Velmi/guitar-dispo/README.md

# guitar-dispo
Digital signal processing on a STM32 Nucleo Board
