Velmi/guitar-dispo/doc/report/notes.txt

- Latenz/Delay
- RTOS
- Filterlänge, Cutoff
- Fensterung?
- Realtime
