Velmi/guitar-dispo/doc/report/sources/acro.tex

\section*{List of Abbreviations}

\begin{acronym}[DMA]
    \acro{ADC}{Analog-Digital Converter}
    \acroplural{ADC}[ADCs]{Analog-Digital Converters}
    \acro{CLI}{Command Line Interface}
    \acro{CPU}{Central Processing Unit}
    \acro{DAC}{Digital-Analog Converter}
    \acro{DMA}{Direct Memory Access}
    \acro{DSP}{Digital Signal Processor}
    \acro{EDA}{Electronic Design Automation}
    \acro{FFT}{Fast Fourier Transform}
    \acro{FIR}{Finite Impulse Response}
    \acro{IC}{Integrated Circuit}
    \acroplural{IC}[ICs]{Integrated Circuits}
    \acro{IDE}{Integrated Development Environment}
    \acro{IIR}{Infinte Impulse Response}
    \acro{I2C}[I\textsuperscript{2}C]{Inter-Integrated Circuit}
    \acro{I2S}[I\textsuperscript{2}S]{Inter-Integrated Sound}
    \acro{LTI}{Linear Time Invariant}
    \acro{LTV}{Linear Time Variant}
    \acro{MSB}{Most Significant Bit}
    \acro{PCB}{Printed Circuit Board}
    \acro{RAM}{Random Access Memory}
    \acro{SPI}{Serial Peripheral Interface}
\end{acronym}
