Velmi/guitar-dispo/doc/report/sources/appendix.tex

\appendix

\section{Schematic}

\includepdf[pages=-]{../../hardware/dispo-board/dispo-board.pdf}

\section{\ac{PCB}}

\begin{figure}[!h]
    \centering
    
    \caption{The built \ac{PCB} with all modifications and connectors}
    \label{fig:pcb}
\end{figure}
