Velmi/guitar-dispo/doc/report/sources/concept.tex

\section{Requirements and concept}

\subsection{Challenges and requirements in Audio Signal Processing}

\subsubsection{Latency}

As we have to sample a block of data in the digital domain, there is a latency between the input and output
depending on some parameters. Firstly the buffer size has a large impact on the latency. The greater the buffer, the
greater the latency. It is application depending what latency is acceptable, this is why that parameter
limits the system and should be evaluated carefully.

Secondly other components, which are application depending, adds latency to the whole signal path.
For example filtering or other modifications take some time to be computed. Also the signal has to
be converted from analog to digital and transmitted over an interface. All these components latencies add
up to an overall system latency. 

In this application, where a guitar signal is processed, the overall latency of the system should be less
than 5\,ms \cite{beckmann_dsp}.

\subsubsection{Packet losses and cracking noise}

In some audio applications cracking noise can occur. This is due to
some impulses on the audio signal. This can be caused by an error of the input sample, for example particles
on a vinyl record, or by slow implementations of digital signal processing algorithms.

If the processing of the input data takes longer than the actual transfer, packets of audio data will
then be dropped. An impulse or step on the output data will be seen, this can be heard as a cracking noise
\cite{stotz_audio_video}.

\subsection{Concept}

The basic concept is shown in \autoref{fig:basic-concept}.

\begin{figure}[!h]
    \centering
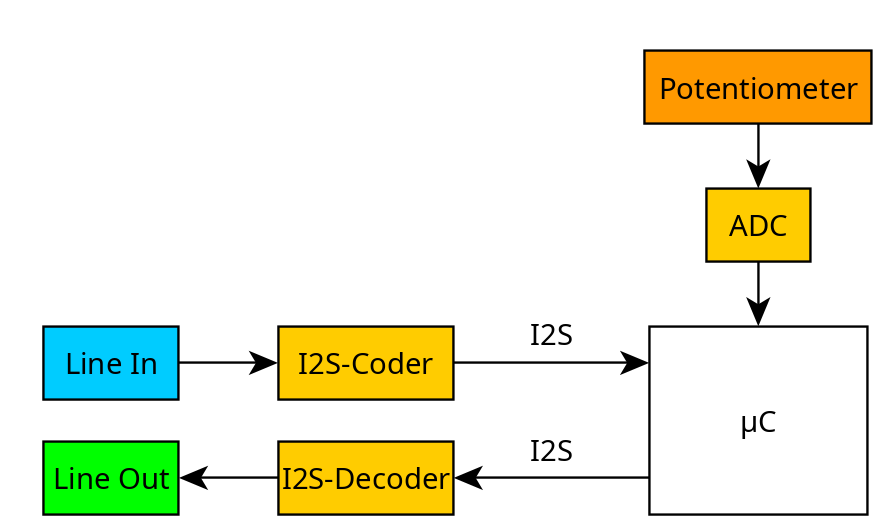
[picture p13: doc/report/img/basic_concept.png]
    
    \caption{Basic concept}
    \label{fig:basic-concept}
\end{figure}

The input data is coming from the Line In, is sampled by a \ac{ADC} and transmitted
over \ac{I2S} to the microcontroller. There the data will be processed and the output will be transmitted
again over \ac{I2S} to a \ac{DAC}. The output is again routed to a Line Jack.

Additionally a potentiometer is connected to set the midfrequency of the filter.

To ensure an adequate sampling rate for audio quality, the frequency is selected to be 48\,kHz.

\subsubsection{Signalflow}

The basic idea is to filter the input signal with a bandpass filter. The mid frequency should be derived
from a potentiometer which is simply connected to an \ac{ADC} inside the microcontroller. It has to be evaluated
how exaclty the filter is adjusted.

The first attempt will be a lookup-table and everytime the position of the
potentiometer changes, the corresponding filter coefficients will be loaded.

The second approach is, to calculate the filter coefficients for a biquad-filter if the value of the potentiometer changes.
This is reasonable to evaluate as the number of coefficients is small in comparison to a \ac{FIR}-filter.

\subsubsection{Double Buffering and DMA}

To solve the problem with packet losses it is recommended to use the double buffering method.
It is basically a buffer which is cut in half. If the first half is filled with data then this half
will be processed while the other half is filled with the second half of the input data. Is the second
half filled then this half will be processed and so on.

The advantage is that it is not necessary to wait for the whole input data block to process.
This will reduce the time between processing and sampling data \cite{eetimes_fund_dsp}.

To take advantage of this, it is useful to combine this technique with a \ac{DMA},
which is already discussed in section \ref{sec:dma}.

%// TODO ausführlicher

The whole procedure is shown in \autoref{fig:double-buffering}.

\begin{figure}[!h]
    \centering
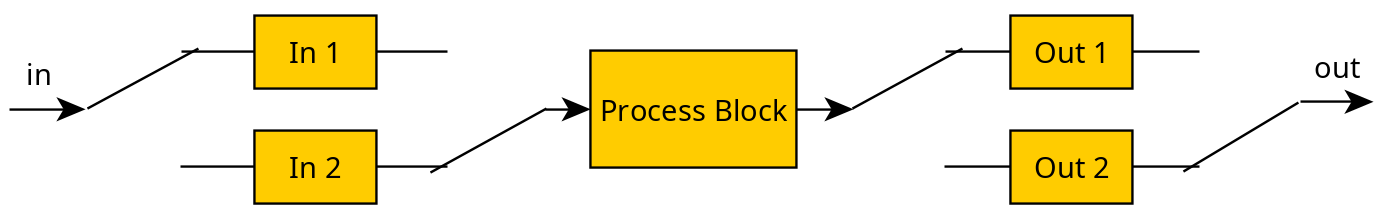
[picture p14: doc/report/img/double_buffering.PNG]
    
    \caption{Double buffering concept \cite{eetimes_fund_dsp}}
    \label{fig:double-buffering}
\end{figure}

\subsubsection{Design criteria}

As the goal is to develop a variable bandpass filter, not only a set of coefficients for one filter has to be stored,
but many versions of this filter with different mid-frequencies.

As a reference, the frequency response of the \textit{Cry-Baby}-Pedal has been measured, which is
shown in \autoref{fig:wahwah-filter}.

\begin{figure}[!h]
    \centering
    \begin{subfigure}[c]{0.45\textwidth}
        \centering
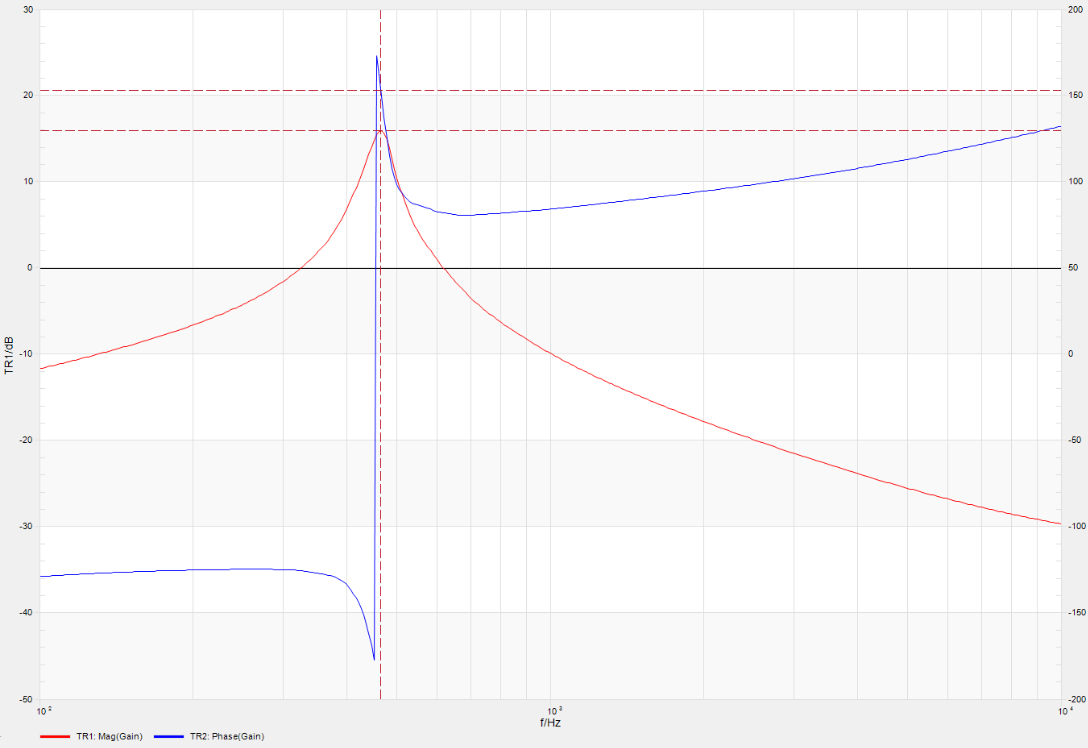
[picture p15: doc/report/img/wahwah-1.png]
        
    \end{subfigure}
    \begin{subfigure}[c]{0.45\textwidth}
        \centering
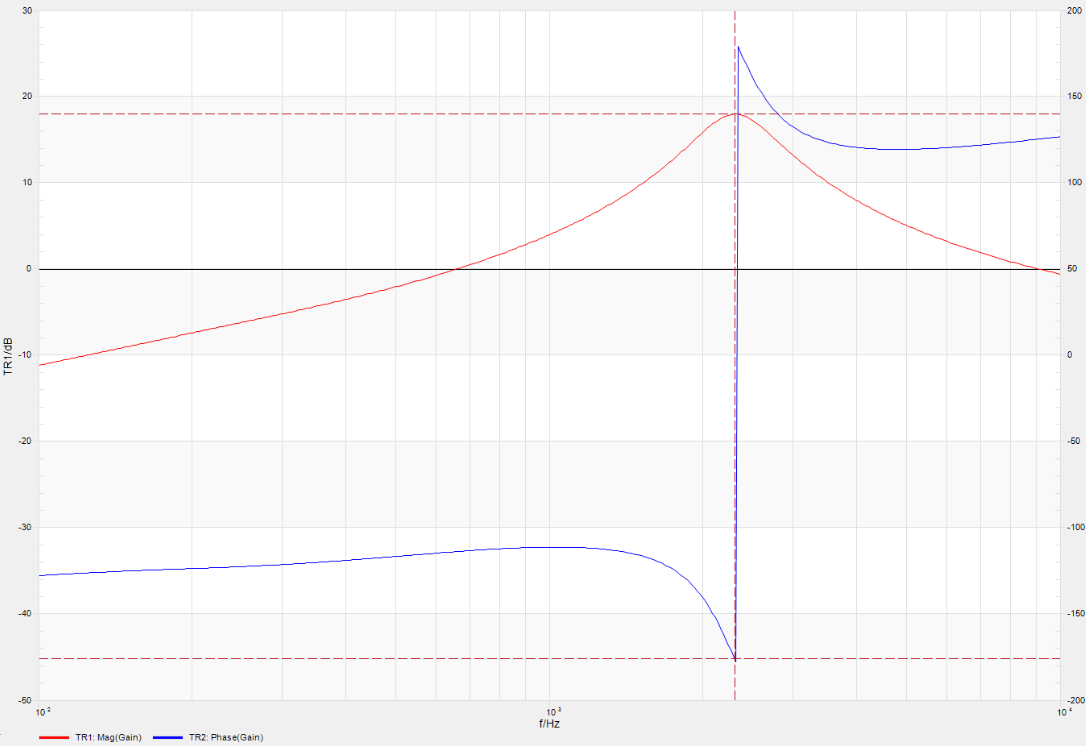
[picture p16: doc/report/img/wahwah-2.png]
        
    \end{subfigure}
    \caption{Measurement of the frequency response of a Wah-Wah-pedal at the lowest and highest frequencies}
    \label{fig:wahwah-filter}
\end{figure}

The resonance frequency of this filter varies between 466\,Hz and 2,3\,kHz.

It is also to be seen, that as the frequency changes, the bandwidth also seem to change. Firstly, it has to be mentioned
that this is a logarithmic scale. Nevertheless, by measuring the bandwidths of this filter, it turns out, that the quality
factor also changes.
The bandwidth at 466\,Hz is measured to be 54\,Hz, which leads to a Q-factor of:

\begin{align}
    Q = \frac{466\,Hz}{54\,Hz} = 8,63
\end{align}

At 2,3\,kHz the bandwidth is 600\,Hz resulting in a quality factor of:

\begin{align}
    Q = \frac{2,3\,kHz}{600\,Hz} = 3,833
\end{align}

To keep the Q-factor constant, with increasing the resonance frequency, the bandwidth also has to increase
(\autoref{eq:q-factor}) \cite{taschenbuch_et}.

For the design of the digital filters, it is assumed, that a constant quality-factor is sufficient to model
the analog reference.

To conclude, there are two design criteria for the filters which can be derived.

\begin{itemize}
    \item mid-frequency varies from 460\,Hz to 2,3\,kHz
    \item it is assumed, that a comparable filter is achieved by using a constant quality-factor of 5
\end{itemize}

Another factor is the buffer size, as it has a direct effect on the overall latency.
Because it is not necessary to use a big buffer size, the choice fell on 128 samples, which means
64 samples per processing step, as double buffering is used. This is also evaluated in later steps.
