Velmi/guitar-dispo/doc/report/sources/titlepage_hka.tex

\definecolor{hkagreen}{RGB}{29, 154, 67}
\begin{titlepage}

    \begin{textblock*}{60px}(160mm,10mm)
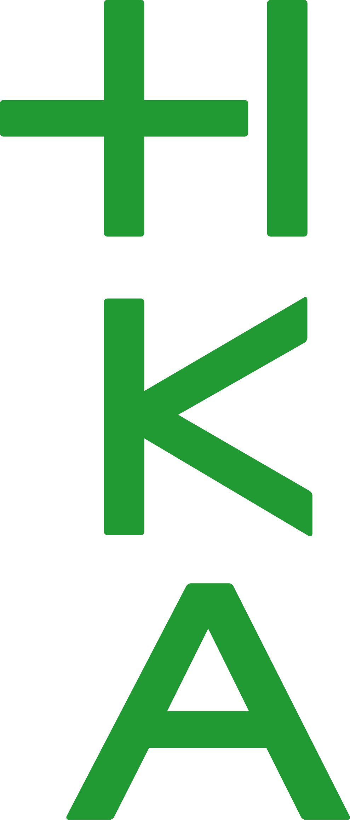
[picture p28: doc/report/img/hka-vertical.png]
		
	\end{textblock*}
    \begin{textblock*}{60px}(30mm,10mm)
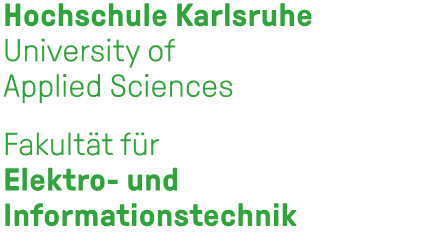
[picture p29: doc/report/img/hka.png]
		
	\end{textblock*}

    \vspace*{5cm}
    \sffamily
    \begingroup
        \fontsize{14pt}{20pt}\selectfont
        \course -\\
        Information Engineering
    \endgroup

    \vspace*{2cm}

    \begingroup
        \fontsize{24pt}{26pt}\selectfont
        \textcolor{hkagreen}{\textbf{Project}}
        \color{black}
    \endgroup

    \vspace*{1cm}

    \begingroup
        \fontsize{20pt}{24pt}\selectfont
        \textbf{\mytitle}
    \endgroup

    \vspace*{7cm}

    \begin{flushleft}
        \begin{tabular}{ll}
            \textbf{Author:} & \myauthor\\
            \textbf{Semester:} & \semester\\
            \textbf{Professor:} & \prof\\
            %\textbf{Abgabetermin:} & \abgabeTermin\\
        \end{tabular}
    \end{flushleft}

    \rmfamily
\end{titlepage}
