Velmi/guitar-dispo/doc/wahwah_presentation.pdf

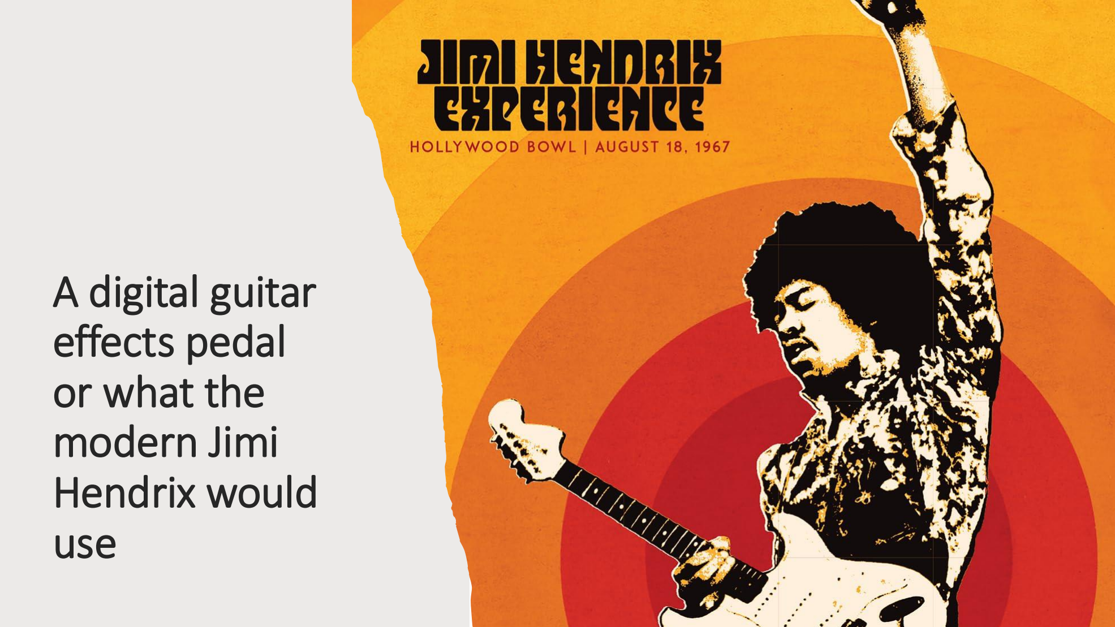
[picture p30: page 1]

## A digital guitar effects pedal or what the modern Jimi Hendrix would use

## Idea

- Digital replica of Wah-Wah pedal

## What is the Wah-Waheffect?

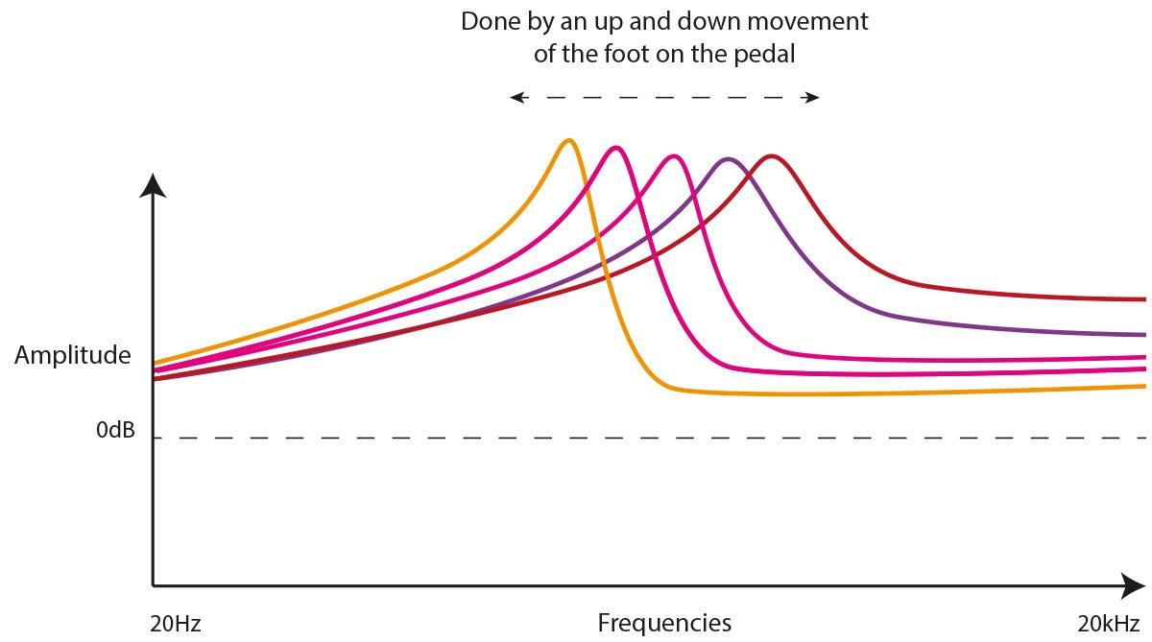
[picture p31: figure]

Source: https://www.3d-varius.com/history-of-the-wah/

## Concept

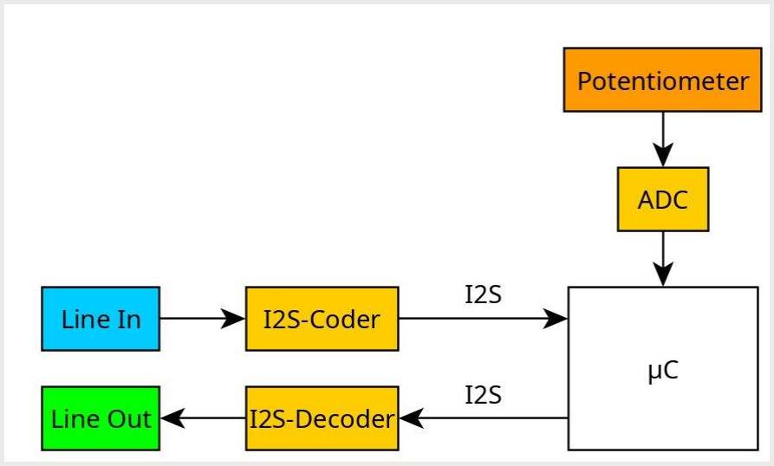
[picture p32: figure]

## Digital Filters

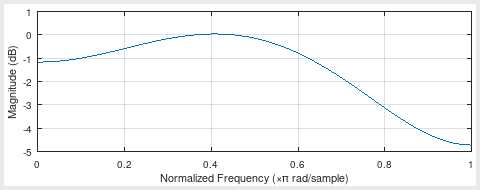
[picture p33: figure]

### FIR

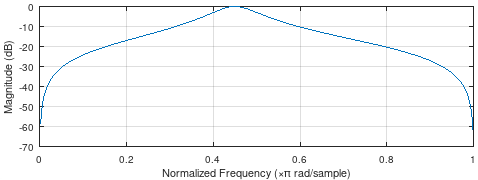
[picture p34: figure]

### IIR

- 5 Coefficients
- Passband from 0.4 to 0.6 Hz

## Biquad Filters

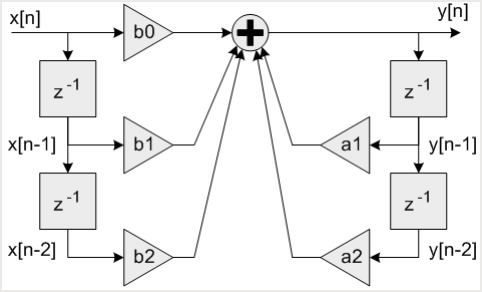
[picture p35: figure]

Source:
https://www.keil.com/pack/doc/CMSIS_Dev/DSP/html/group__BiquadCascadeDF1.html

## Analog reference

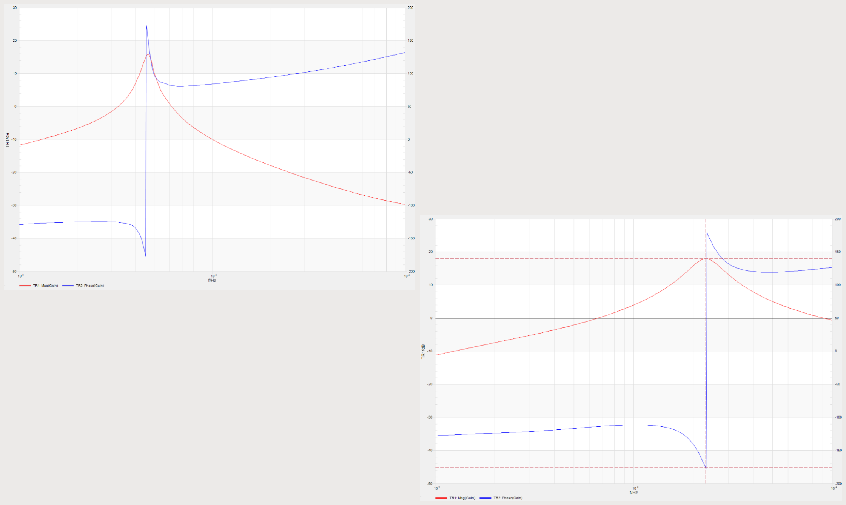
[picture p36: figure]

## Filterdesign

- Constant quality factor 5
- 460 Hz to 2.3 kHz

## FIR Implementation

- 130 coefficients

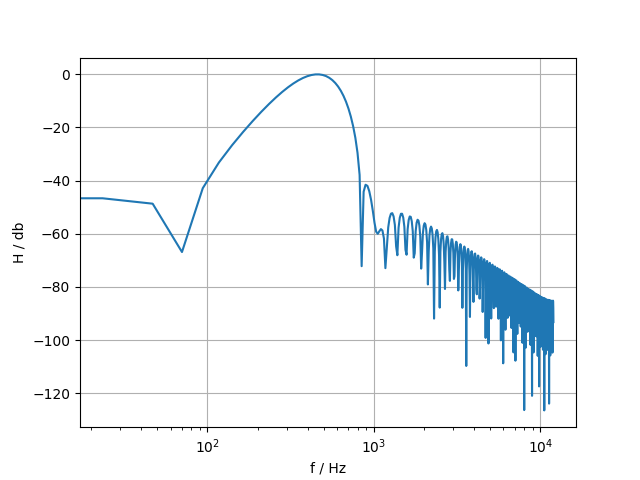
[picture p37: figure]
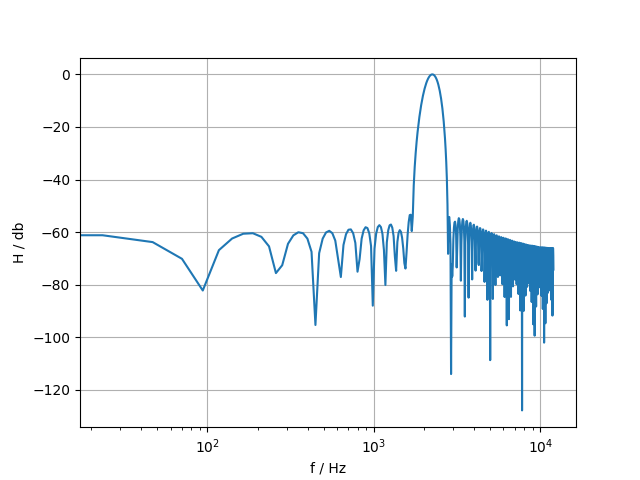
[picture p38: figure]

## IIR Implementation

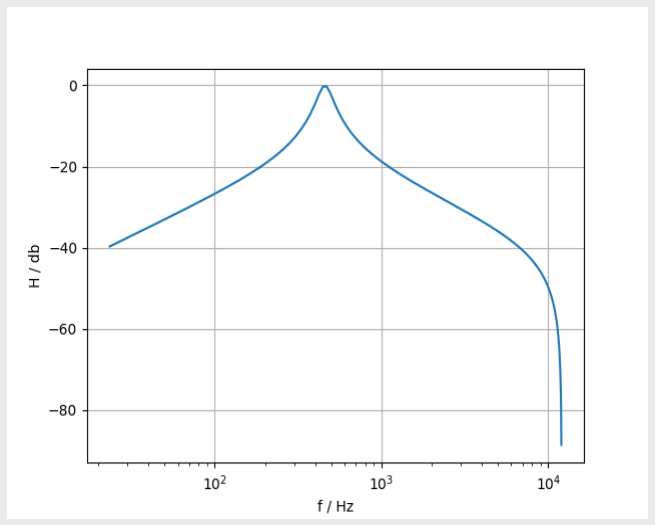
[picture p39: figure]
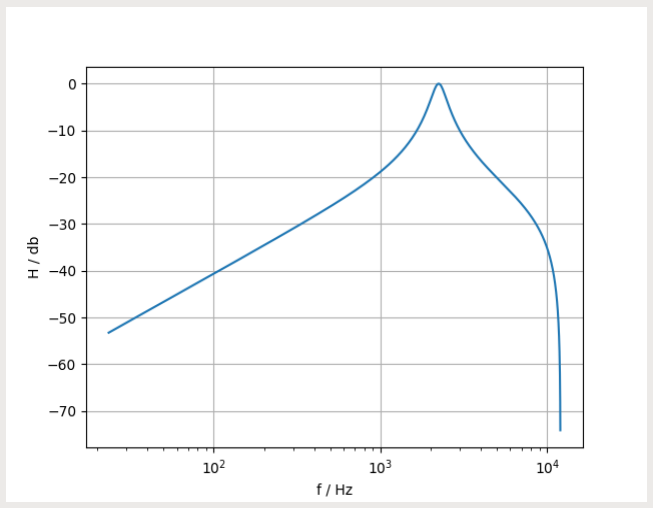
[picture p40: figure]

- Biquad filter
- 5 coefficients

## FIR Implementation -Measurement

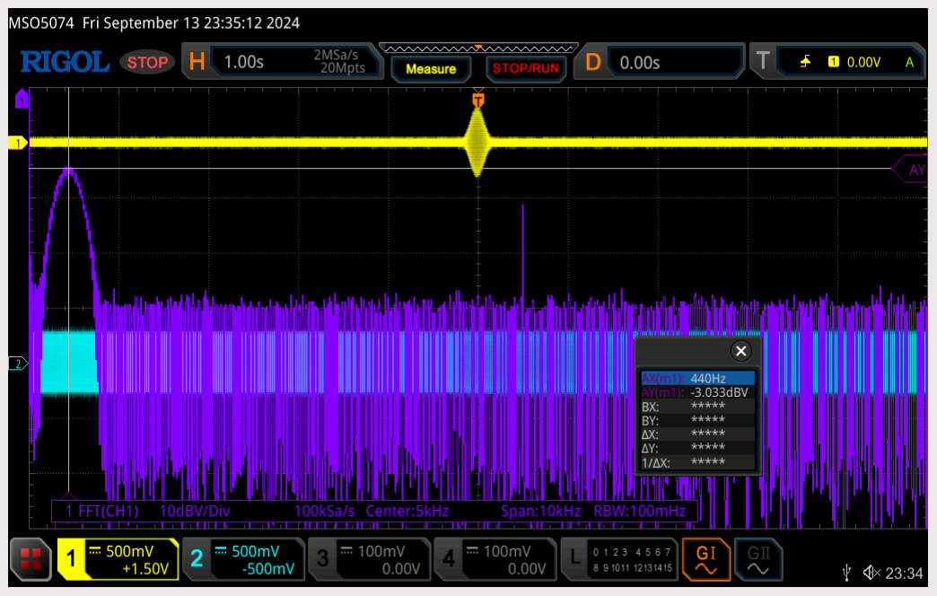
[picture p41: figure]
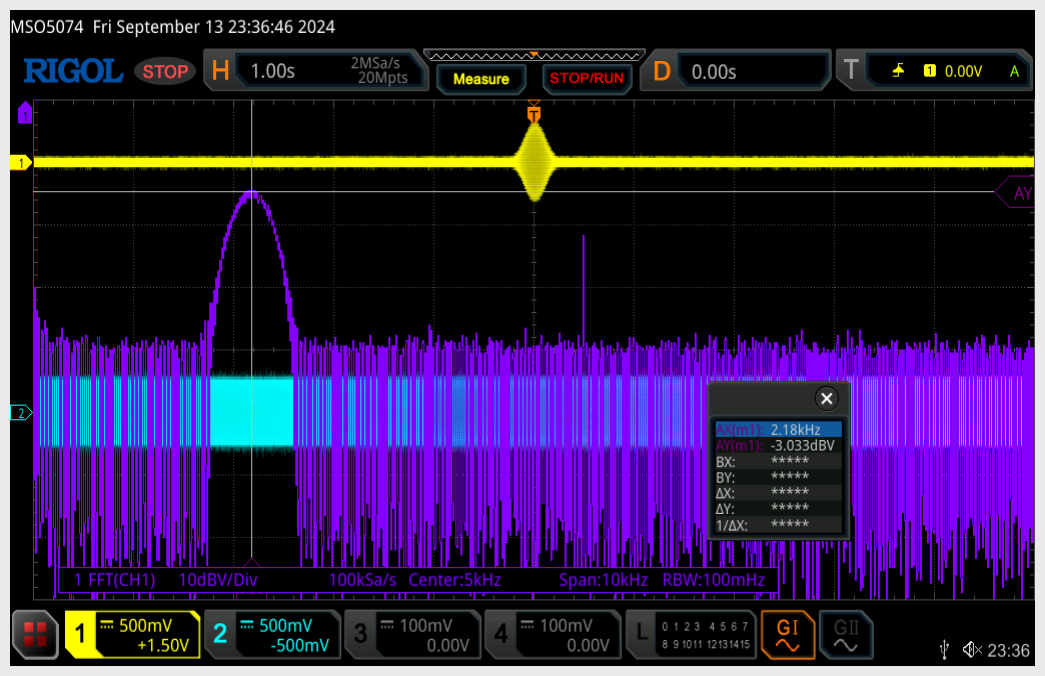
[picture p42: figure]

## IIR Implementation -Measurement

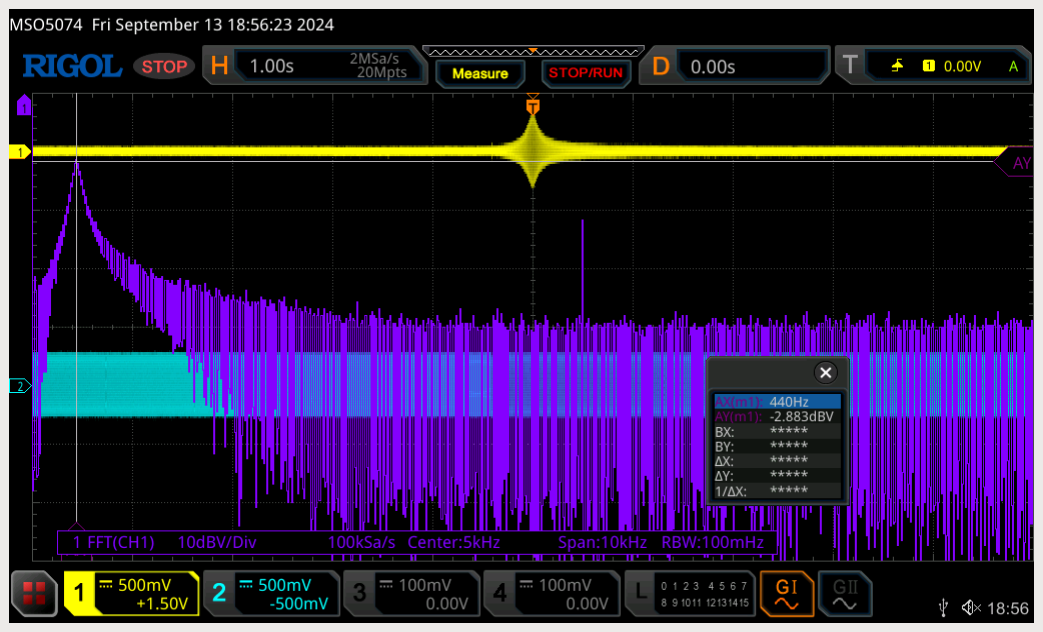
[picture p43: figure]
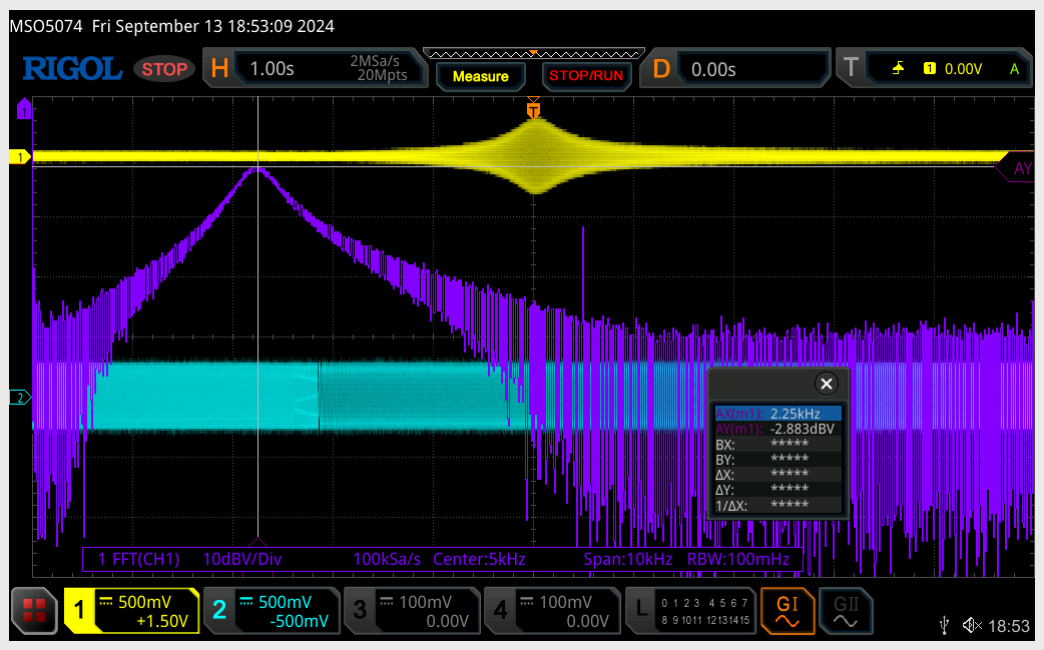
[picture p44: figure]

## Demo

## Conclusion

- Replica of Wah-Wah-pedal successful
- FIR not suitable
- Single-stage biquad filter provide appropriate results
- Base for additional effects
