Velmi/guitar-dispo/doc/report/img/analog_bandpass.png

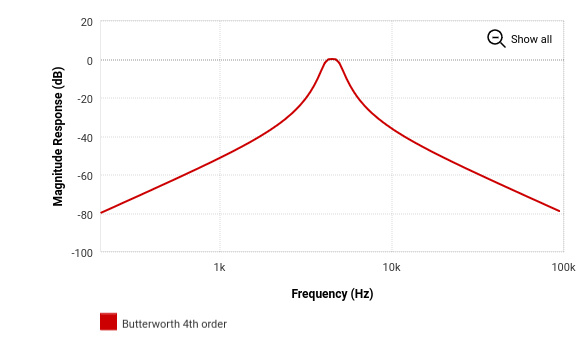
doc/report/img/analog_bandpass.png
