Velmi/guitar-dispo/doc/report/img/double_buffering_dma.PNG

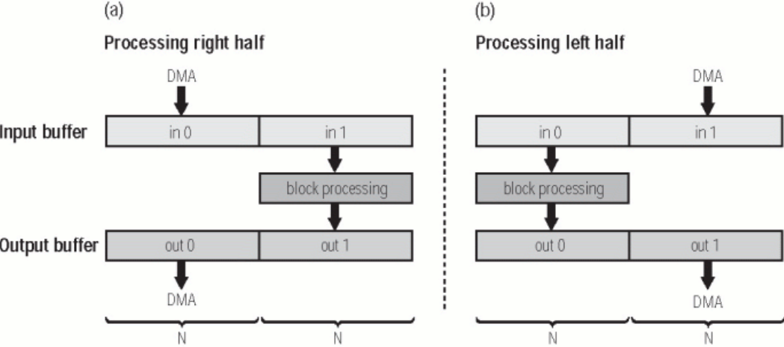
doc/report/img/double_buffering_dma.PNG
