Velmi/guitar-dispo/doc/report/img/hka2.png

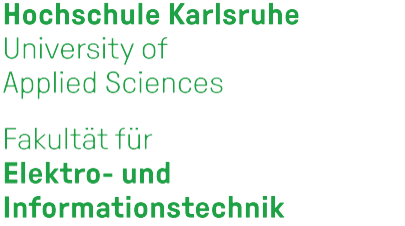
doc/report/img/hka2.png
