Velmi/guitar-dispo/doc/report/img/passthrough.png

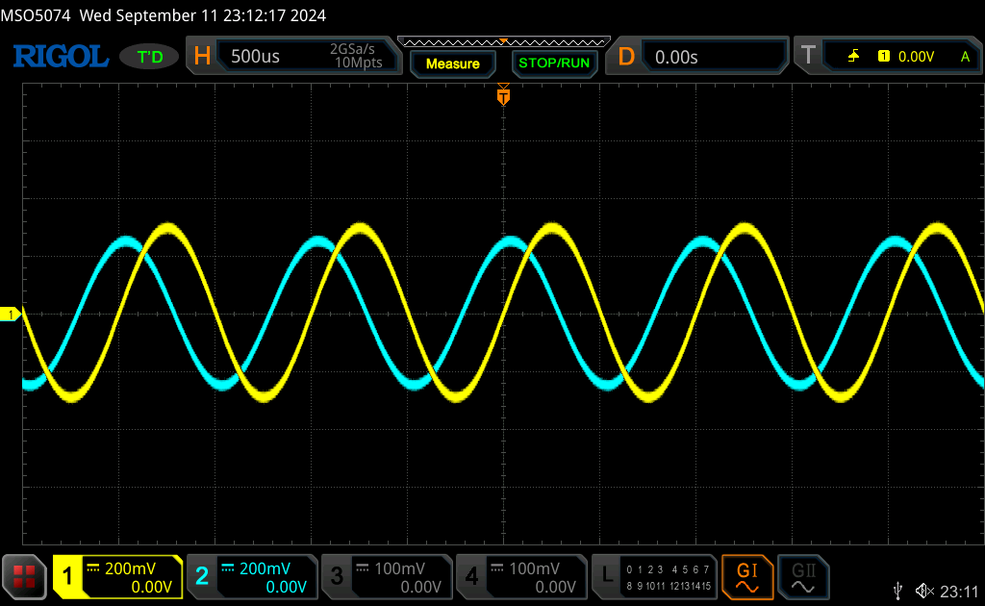
doc/report/img/passthrough.png
