Velmi/guitar-dispo/hardware/dispo-board/bom_expanded.ods

Source: | /run/media/markus/Daten/git/guitar-dispo/hardware/dispo-board/dispo-board.kicad_sch
Date: | Do 02 Mai 2024 22:40:40 CST | 2
Tool: | Eeschema 7.0.10
Generator: | /usr/share/kicad/plugins/bom_csv_grouped_by_value.py
Component Count: | 99
Collated Components:
Item | Qty | Reference(s) | Value | LibPart | Footprint | Datasheet | DNP | Exact Model | MOUSER_NR | THOMANN_NR | CONRAD_NR | REICHELT_NR
1 | 22 | C1, C2, C3, C4, C5, C6, C12, C24, C28, C30, C35 | 100n | Device:C | Capacitor_SMD:C_0402_1005Metric | https://www.mouser.de/datasheet/2/281/1/GRM155R61A104KA01_02A-1983866.pdf |  |  | 81-GRM15R61A104KA01J
2 | 10 | C7, C27, C29, C34, C36 | 10u | Device:C | Capacitor_SMD:C_0603_1608Metric | https://www.mouser.de/datasheet/2/281/1/GRM188C81A106MA73_01A-1985758.pdf |  |  | 81-GRM188C81A106MA3D
3 | 6 | C8, C14, C33 | 10n | Device:C | Capacitor_SMD:C_0402_1005Metric | https://www.mouser.de/datasheet/2/281/1/GRM1555CYA103GE01_01A-1983577.pdf |  |  | 81-GRM1555CYA103GE1D
4 | 16 | C9, C10, C13, C17, C20, C21, C22, C23 | 1u | Device:C | Capacitor_SMD:C_0603_1608Metric | https://www.mouser.de/datasheet/2/281/1/GRM185R61C105KE44_01A-1984567.pdf |  |  | 81-GRM185R61C105KE4J
5 | 6 | C11, C18, C19 | 2u2 | Device:C | Capacitor_SMD:C_0603_1608Metric | https://www.mouser.de/datasheet/2/281/1/GRM188R71A225KE15_04A-1985813.pdf |  |  | 81-GRM188R71A225KE5J
6 | 4 | C15, C16 | 16p | Device:C | Capacitor_SMD:C_0402_1005Metric | https://www.mouser.de/datasheet/2/281/1/GRM1555C1H160GA01_01A-1982731.pdf |  |  | 81-GRM1555C1H160GA1D
7 | 4 | C25, C32 | 1u | Device:C | Capacitor_SMD:C_1206_3216Metric | https://www.cde.com/resources/catalogs/FCA.pdf |  |  | 598-FCA1206A105M-H3
8 | 2 | C26 | 180p | Device:C | Capacitor_SMD:C_0402_1005Metric | https://www.mouser.de/datasheet/2/281/1/GRM1555C1H181JA01_01A-1982678.pdf |  |  | 81-GRM1555C1H181JA1J
9 | 2 | C31 | 3u3 | Device:C | Capacitor_SMD:C_0603_1608Metric | https://www.mouser.de/datasheet/2/977/e_MU-1600877.pdf |  |  | 232-16MU335MB33225
10 | 6 | D1, D2, D3 | LED power | Device:LED | LED_SMD:LED_0603_1608Metric | https://www.mouser.de/datasheet/2/109/C18661-3159417.pdf |  |  | 645-598-8N80-107F
11 | 2 | FB1 | 120R | Device:FerriteBead | Resistor_SMD:R_0402_1005Metric | https://www.mouser.de/datasheet/2/281/1/Murata_4_42023_QNFA9103SH-3135182.pdf |  |  | 81-BLM15PX121SH1D
12 | 10 | J1, J2, J3, J12, J13 | Conn_01x03 | Connector_Generic:Conn_01x03 | MyFootprints:solder_pad_1x03_D3.5mm | ~
13 | 2 | J4 | Conn_01x04 | Connector_Generic:Conn_01x04 | Connector_PinHeader_2.54mm:PinHeader_1x04_P2.54mm_Vertical | ~
14 | 2 | J5 | USB_B_Micro | Connector:USB_B_Micro | Connector_USB:USB_Micro-B_Molex_47346-0001 | ~ |  |  | 538-47346-1001
15 | 12 | J6, J7, J8, J9, J10, J11 | Conn_01x02 | Connector_Generic:Conn_01x02 | MyFootprints:solder_pad_1x02_D3.5mm | ~
16 | 2 | J14 | Conn_ARM_JTAG_SWD_10 | Connector:Conn_ARM_JTAG_SWD_10 | Connector_PinHeader_1.27mm:PinHeader_2x05_P1.27mm_Vertical | http://infocenter.arm.com/help/topic/com.arm.doc.ddi0314h/DDI0314H_coresight_components_trm.pdf |  |  | 474-PRT-15362
17 | 4 | JP1, JP2 | Jumper_3_Open | Jumper:Jumper_3_Open | Connector_PinHeader_2.54mm:PinHeader_1x03_P2.54mm_Vertical | ~
18 | 6 | R1, R3, R4 | 180 | Device:R | Resistor_SMD:R_0603_1608Metric | https://www.mouser.de/datasheet/2/54/cr-1858361.pdf |  |  | 652-CR0603JW-181ELF
19 | 22 | R2, R5, R6, R7, R8, R9, R10, R11, R13, R16, R19 | 10k | Device:R | Resistor_SMD:R_0402_1005Metric | https://www.vishay.com/docs/28773/crcwce3.pdf |  |  | 71-CRCW040210K0FKEDC
20 | 4 | R12, R17 | 22 | Device:R | Resistor_SMD:R_0603_1608Metric | https://www.mouser.de/datasheet/2/54/Bourns_1_11_2023_CHP_Q_datasheet-3084758.pdf |  |  | 652-CHP0603QJW-220E
21 | 2 | R14 | 1k | Device:R | Resistor_SMD:R_0402_1005Metric | ~ |  |  | 71-CRCW0402-1.0K-E3
22 | 4 | R15, R21 | 100k | Device:R | Resistor_SMD:R_0603_1608Metric | https://www.vishay.com/docs/28952/mcs0402at-mct0603at-mcu0805at-mca1206at.pdf |  |  | 594-MCT0603MG1003BP5
23 | 2 | R18 | 470 | Device:R | Resistor_SMD:R_0402_1005Metric | https://www.mouser.de/datasheet/2/315/Panasonic_ERA-3305500.pdf |  |  | 667-ERA-2VEB4700X
24 | 2 | R20 | 0 | Device:R | Resistor_SMD:R_0402_1005Metric | https://www.we-online.com/components/products/datasheet/560112110001.pdf |  |  | 710-560112110001
25 | 2 | R22 | DNP | Device:R | Resistor_SMD:R_0402_1005Metric | ~
26 | 4 | RV1, RV2 | Potentiometer | Device:R_Potentiometer_Trim | Potentiometer_SMD:Potentiometer_Bourns_3224W_Vertical | https://www.mouser.de/datasheet/2/54/3224-776900.pdf |  |  | 652-3224W-1-503E
27 | 2 | SW1 | SW_Push | Switch:SW_Push | Button_Switch_SMD:SW_Push_1P1T_NO_6x6mm_H9.5mm | https://www.mouser.de/datasheet/2/418/1/NG_CD_2-1437565-7_V-689165.pdf |  |  | 506-FSM2JSMAATR
28 | 22 | TP1, TP2, TP3, TP4, TP5, TP6, TP7, TP8, TP9, TP10, TP11 | TestPoint | Connector:TestPoint | TestPoint:TestPoint_Pad_D1.5mm | ~
29 | 2 | U1 | TPS79633DCQ | MySymbols:TPS79633DCQ | Package_TO_SOT_SMD:SOT-223-6 | https://www.ti.com/general/docs/suppproductinfo.tsp?distId=26 |  |  | 595-TPS79633DCQ
30 | 2 | U2 | STM32H725RGV6 | MCU_ST_STM32H7:STM32H725RGVx | Package_DFN_QFN:QFN-68-1EP_8x8mm_P0.4mm_EP6.4x6.4mm | https://www.st.com/resource/en/datasheet/stm32h725rg.pdf |  |  | 511-STM32H725RGV6
31 | 4 | U3, U5 | OPA1671 | MySymbols:OPAmp | Package_TO_SOT_SMD:SOT-23-5 | https://www.ti.com/lit/ds/symlink/opa1671.pdf?ts=1712400587031 |  |  | 595-OPA1671IDBVT
32 | 2 | U4 | CS5343-CZZ | Audio:CS5343 | Package_SO:TSSOP-10_3x3mm_P0.5mm | https://statics.cirrus.com/pubs/proDatasheet/CS5343-44_F5.pdf |  |  | 777-CS5343-CZZ
33 | 2 | U6 | CS4344-CZZR | Audio:CS4344 | Package_SO:TSSOP-10_3x3mm_P0.5mm | https://statics.cirrus.com/pubs/proDatasheet/CS4344-45-48_F2.pdf |  |  | 777-CS4344-CZZR
34 | 2 | Y1 | 32M | Device:Crystal_GND24 | Crystal:Crystal_SMD_2016-4Pin_2.0x1.6mm | https://www.mouser.de/datasheet/2/3/ABM11W-1774757.pdf |  | ABM11W-32.0000MHZ-8-D1X-T3 | 815-11W32-8D1XT
35 | 2 | ~ | ~ | ~ | ~ | https://www.mouser.de/datasheet/2/418/7/ENG_CD_826629_AC1-2068647.pdf |  |  | 571-1-826629-2
36 | 4 | ~ | ~ | ~ | ~ |  |  |  |  | 189475 |  | EBM 63
37 | 1 | ~ | ~ | ~ |  |  |  |  | 426-FIT0140
38 | 2 | ~ | ~ | ~ | ~ |  |  |  |  | 202411 | 1606031 - VQ
