Velmi/guitar-dispo/doc/report/img/fir_measure_460_bartlett.png

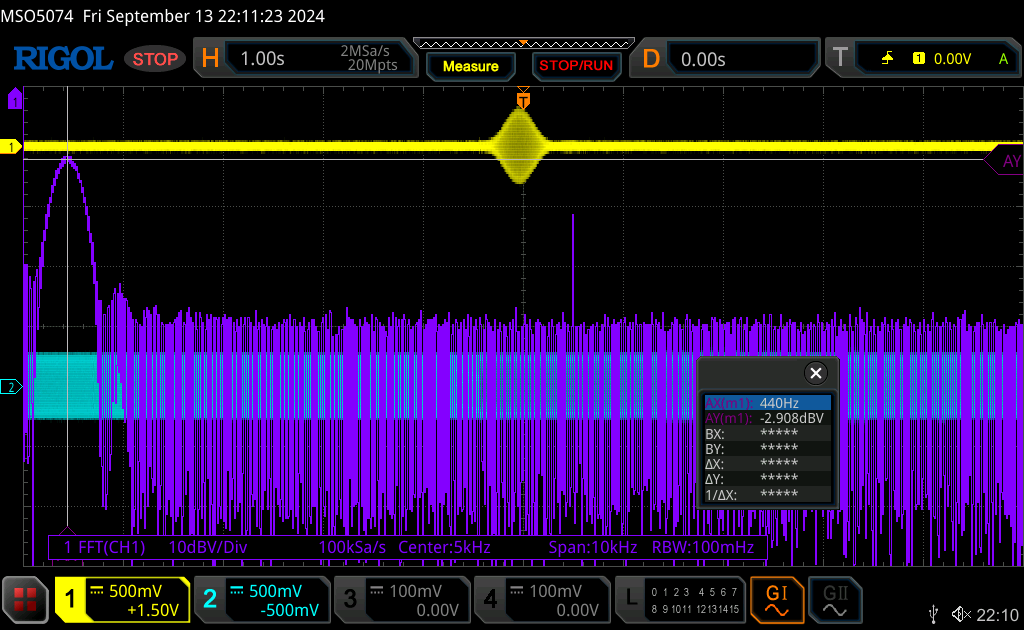
doc/report/img/fir_measure_460_bartlett.png
