Velmi/guitar-dispo/doc/report/img/fir_measure_2242_bartlett.png

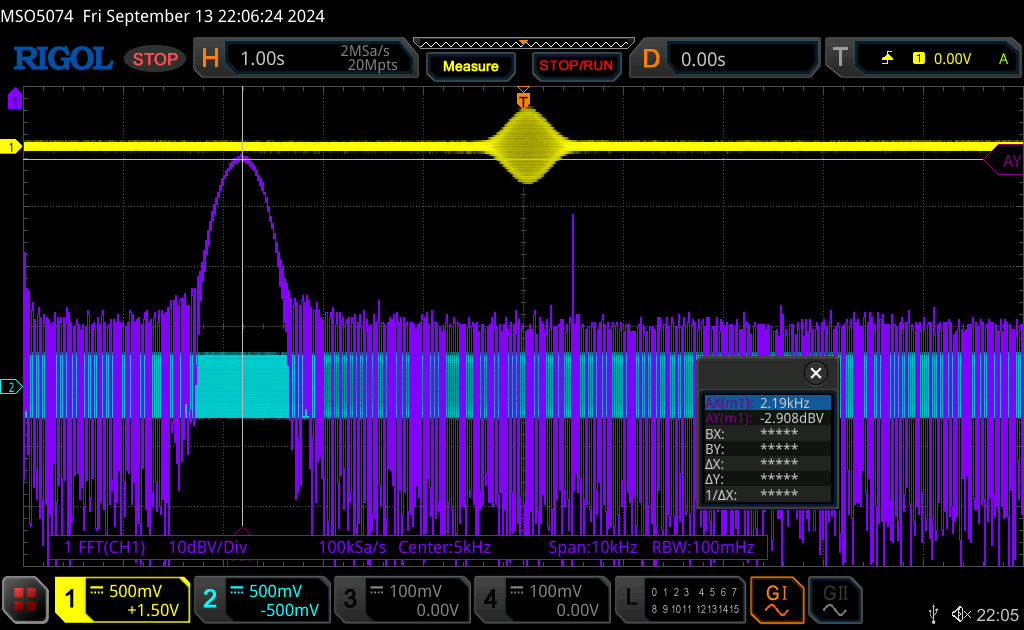
doc/report/img/fir_measure_2242_bartlett.png
