Velmi/guitar-dispo/doc/report/img/fir_measure_2242_blackman.png

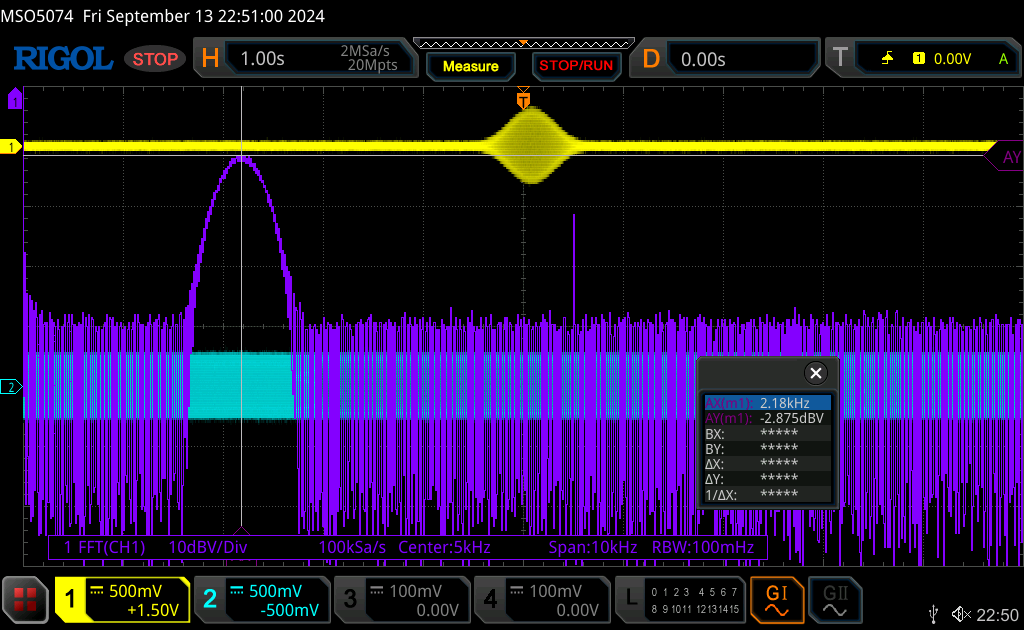
doc/report/img/fir_measure_2242_blackman.png
