Velmi/guitar-dispo/hardware/dispo-board/dispo-board.pdf

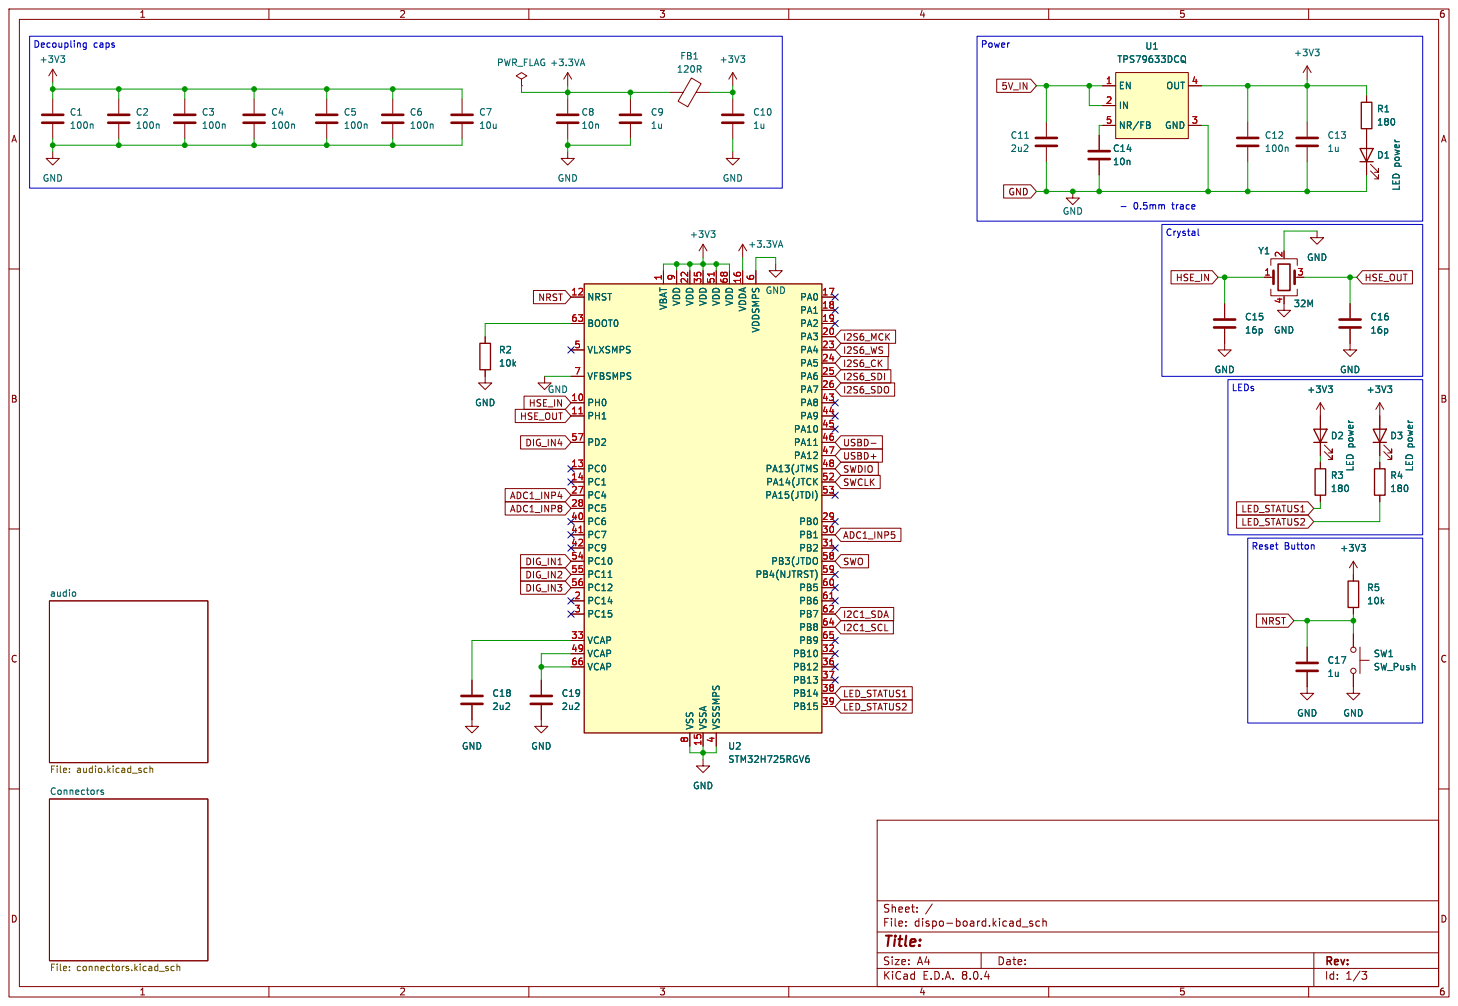
[picture p71: page 1]

Id: 1/3 Title: File: dispo-board.kicad_sch Sheet: / Connectors File: connectors.kicad_sch

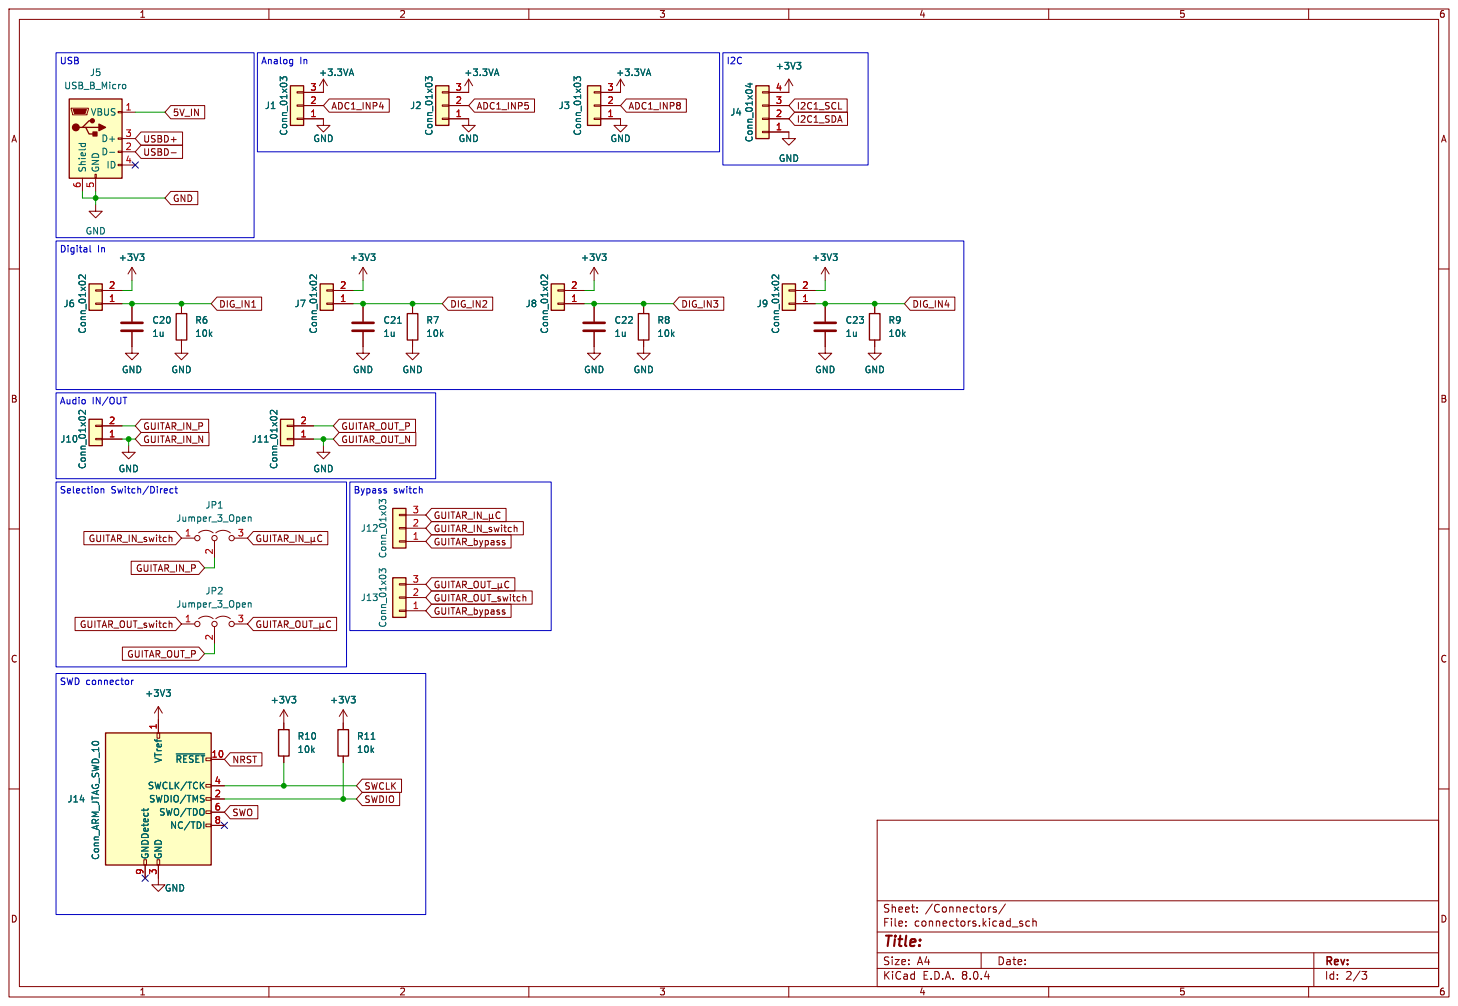
[picture p72: page 2]

3 SWCLK/TCK 4 SWO/TDO 6 NC/TDI 8 GNDDetect 9 +3V3 +3V3 +3V3 R10

3 SWCLK/TCK 4 SWO/TDO 6 NC/TDI 8 GNDDetect 9

Id: 2/3 Title: File: connectors.kicad_sch Sheet: /Connectors/

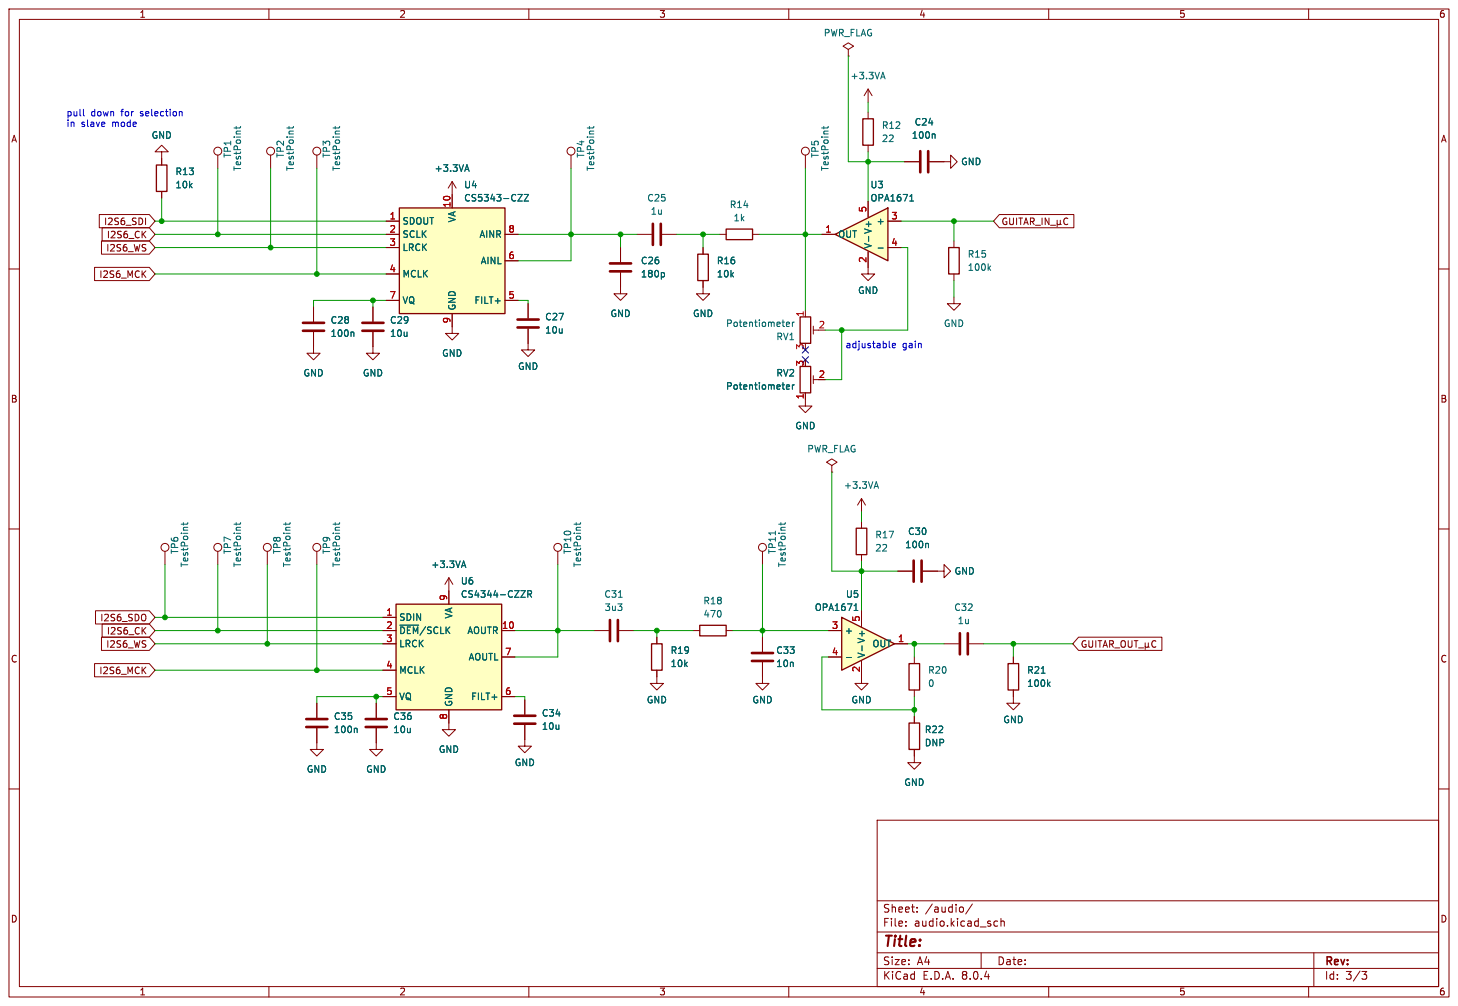
[picture p73: page 3]

pull down for selection
in slave mode

Id: 3/3 Title: File: audio.kicad_sch Sheet: /audio/
