Velmi/guitar-dispo/hardware/dispo-board/dispo-board.kicad_pcb

## KiCad design hardware/dispo-board/dispo-board.kicad_pcb (2026-01-25)

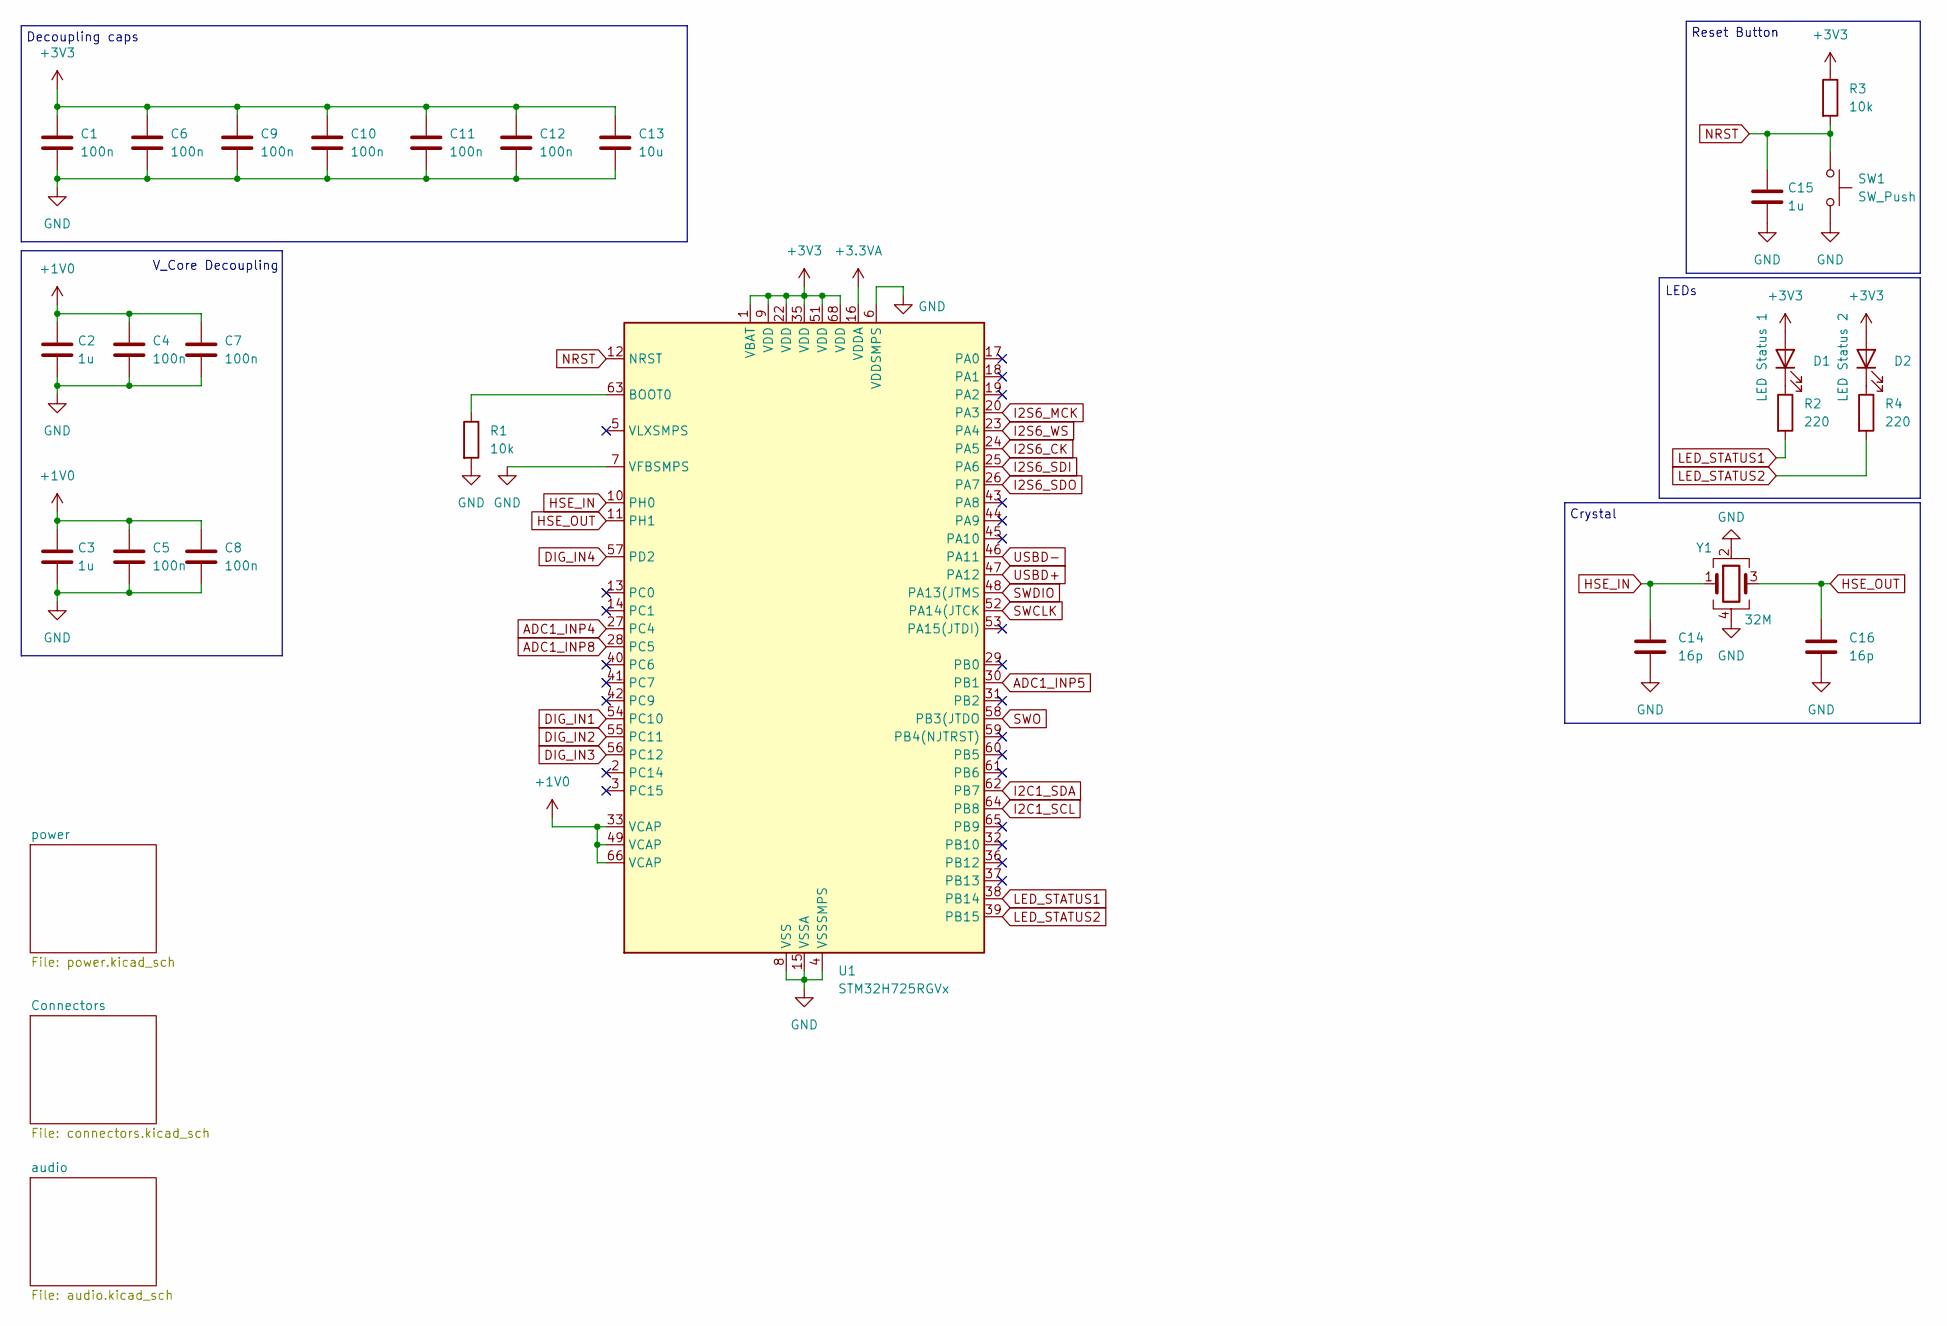
[picture p74: schematic dispo-board.kicad_sch]

Parts:
C1, C4, C5, C6, C7, C8, C9, C10, C11, C12: 100n; C_0402_1005Metric; MOUSER_NR 963-MCASL105SB7104KF
C2, C3, C15: 1u; C_0402_1005Metric; MOUSER_NR 963-LMK105BJ105MVHF
C13: 10u; C_0603_1608Metric; MOUSER_NR 963-LMK107BBJ106MALT
C14, C16: 16p; C_0402_1005Metric; MOUSER_NR 81-GCM1555C1H160FA6D
D1: LED Status 1; LED_0603_1608Metric; MOUSER_NR 645-598-8N80-107F
D2: LED Status 2; LED_0603_1608Metric; MOUSER_NR 645-598-8N80-107F
R1, R3: 10k; R_0402_1005Metric; MOUSER_NR 652-CR0402-JW-103GLF
R2, R4: 220; R_0402_1005Metric; MOUSER_NR 652-CR0402FX-2200GLF
SW1: SW_Push; SW_Push_1P1T_NO_CK_KSC7xxJ; MOUSER_NR 506-FSM2JSMAATR
U1: STM32H725RGVx; QFN-68-1EP_8x8mm_P0.4mm_EP6.4x6.4mm
Y1: 32M; Crystal_SMD_2016-4Pin_2.0x1.6mm; MOUSER_NR 815-11W32-8D1XT

Connections:
+1V0: C2.1, C3.1, C4.1, C5.1, C7.1, C8.1, U1.33 (VCAP), U1.49 (VCAP), U1.66 (VCAP); also elsewhere on the board
+3.3VA: U1.16 (VDDA); also elsewhere on the board
+3V3: C1.1, C6.1, C9.1, C10.1, C11.1, C12.1, C13.1, D1.2 (A), D2.2 (A), R3.1, U1.1 (VBAT), U1.9 (VDD), U1.22 (VDD), U1.35 (VDD), U1.51 (VDD), U1.68 (VDD); also elsewhere on the board
ADC1_INP4: U1.27 (PC4); also elsewhere on the board
ADC1_INP5: U1.30 (PB1); also elsewhere on the board
ADC1_INP8: U1.28 (PC5); also elsewhere on the board
DIG_IN1: U1.54 (PC10); also elsewhere on the board
DIG_IN2: U1.55 (PC11); also elsewhere on the board
DIG_IN3: U1.56 (PC12); also elsewhere on the board
DIG_IN4: U1.57 (PD2); also elsewhere on the board
GND: C1.2, C2.2, C3.2, C4.2, C5.2, C6.2, C7.2, C8.2, C9.2, C10.2, C11.2, C12.2, C13.2, C14.2, C15.2, C16.2, R1.2, SW1.2, U1.4 (VSSSMPS), U1.6 (VDDSMPS), U1.7 (VFBSMPS), U1.8 (VSS), U1.15 (VSSA), U1.21 (VSS), U1.34 (VSS), U1.50 (VSS), U1.67 (VSS), U1.69 (VSS), Y1.2, Y1.4; also elsewhere on the board
HSE_IN: C14.1, U1.10 (PH0), Y1.1
HSE_OUT: C16.1, U1.11 (PH1), Y1.3
I2C1_SCL: U1.64 (PB8); also elsewhere on the board
I2C1_SDA: U1.62 (PB7); also elsewhere on the board
I2S6_CK: U1.24 (PA5); also elsewhere on the board
I2S6_MCK: U1.20 (PA3); also elsewhere on the board
I2S6_SDI: U1.25 (PA6); also elsewhere on the board
I2S6_SDO: U1.26 (PA7); also elsewhere on the board
I2S6_WS: U1.23 (PA4); also elsewhere on the board
LED_STATUS1: R2.2, U1.38 (PB14)
LED_STATUS2: R4.2, U1.39 (PB15)
NRST: C15.1, R3.2, SW1.1, U1.12 (NRST); also elsewhere on the board
unnamed: D1.1 (K), R2.1
unnamed: D2.1 (K), R4.1
unnamed: R1.1, U1.63 (BOOT0)
SWCLK: U1.52 (PA14(JTCK); also elsewhere on the board
SWDIO: U1.48 (PA13(JTMS); also elsewhere on the board
SWO: U1.58 (PB3(JTDO); also elsewhere on the board
USBD+: U1.47 (PA12); also elsewhere on the board
USBD-: U1.46 (PA11); also elsewhere on the board

Notes on the sheet:
V_Core Decoupling
Decoupling caps
Crystal
Reset Button
LEDs

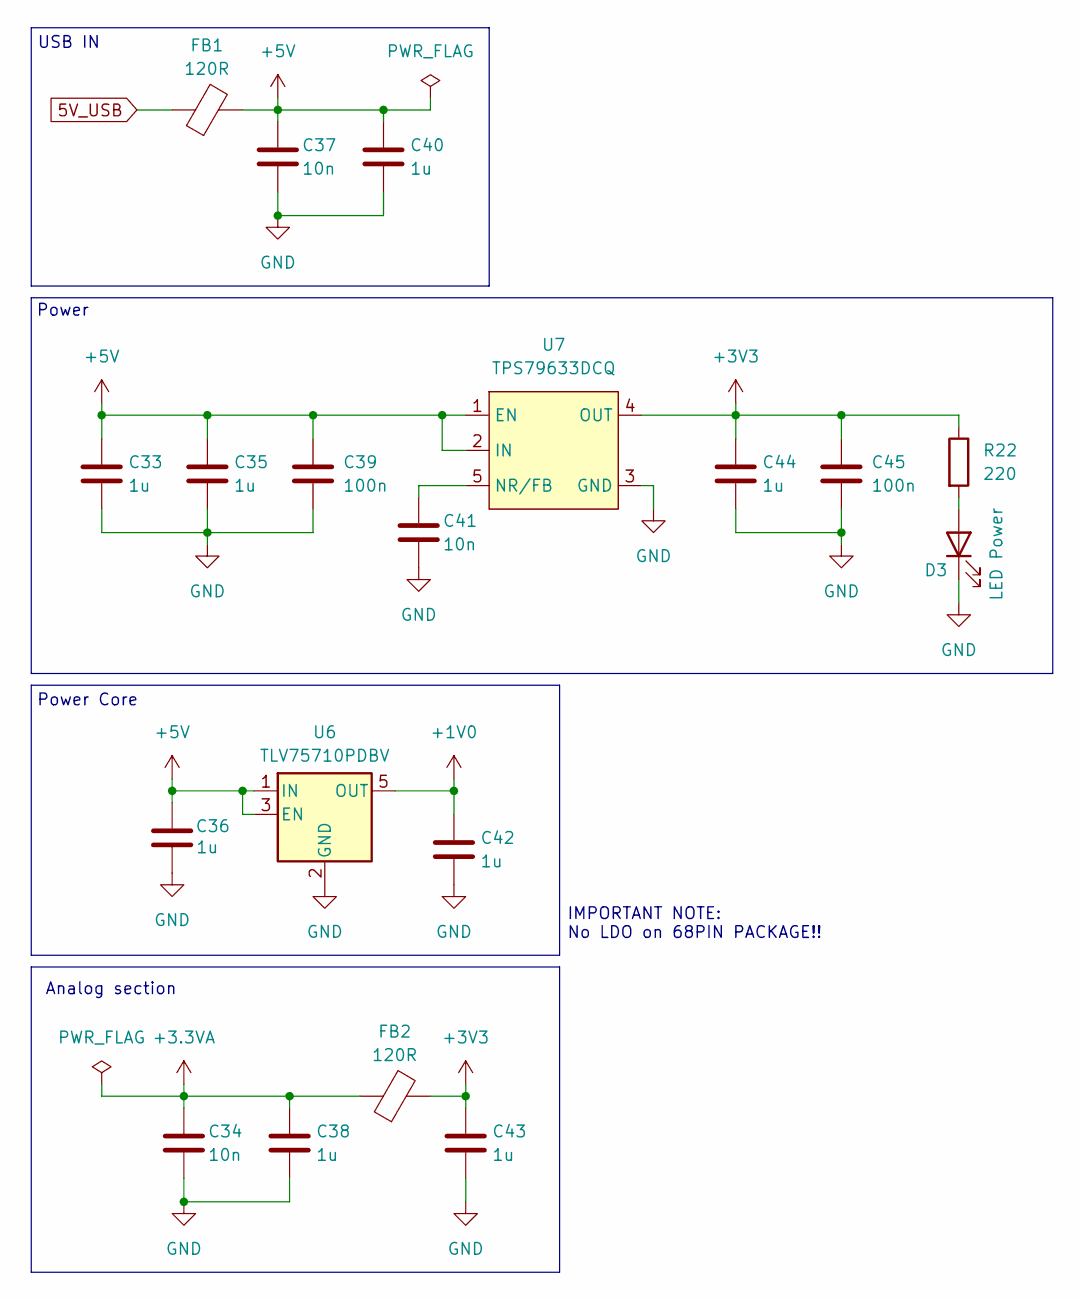
[picture p75: schematic power.kicad_sch]

Parts:
C33, C35, C36, C38, C40, C42, C43, C44: 1u; C_0402_1005Metric; MOUSER_NR 963-LMK105BJ105MVHF
C34, C37, C41: 10n; C_0402_1005Metric; MOUSER_NR 81-GRM155R61A103KA1D
C39, C45: 100n; C_0402_1005Metric; MOUSER_NR 963-MCASL105SB7104KF
D3: LED Power; LED_0603_1608Metric; MOUSER_NR 645-598-8N80-107F
FB1, FB2: 120R; R_0402_1005Metric; MOUSER_NR 81-BLM15PX121SH1D
R22: 220; R_0402_1005Metric; MOUSER_NR 652-CR0402FX-2200GLF
U6: TLV75710PDBV; SOT-23-5
U7: TPS79633DCQ; SOT-223-6; MOUSER_NO 595-TPS79633DCQ

Connections:
5V_USB: FB1.1; also elsewhere on the board
+1V0: C42.1, U6.5 (OUT); also elsewhere on the board
+3.3VA: C34.1, C38.1, FB2.1; also elsewhere on the board
+3V3: C43.1, C44.1, C45.1, FB2.2, R22.1, U7.4 (OUT); also elsewhere on the board
+5V: C33.1, C35.1, C36.1, C37.1, C39.1, C40.1, FB1.2, U6.1 (IN), U6.3 (EN), U7.1 (EN), U7.2 (IN)
GND: C33.2, C34.2, C35.2, C36.2, C37.2, C38.2, C39.2, C40.2, C41.2, C42.2, C43.2, C44.2, C45.2, D3.1 (K), U6.2 (GND), U7.3 (GND), U7.6 (GND); also elsewhere on the board
unnamed: D3.2 (A), R22.2
unnamed: C41.1, U7.5 (NR/FB)

Notes on the sheet:
USB IN
Power
Power Core
IMPORTANT NOTE: No LDO on 68PIN PACKAGE!!
Analog section

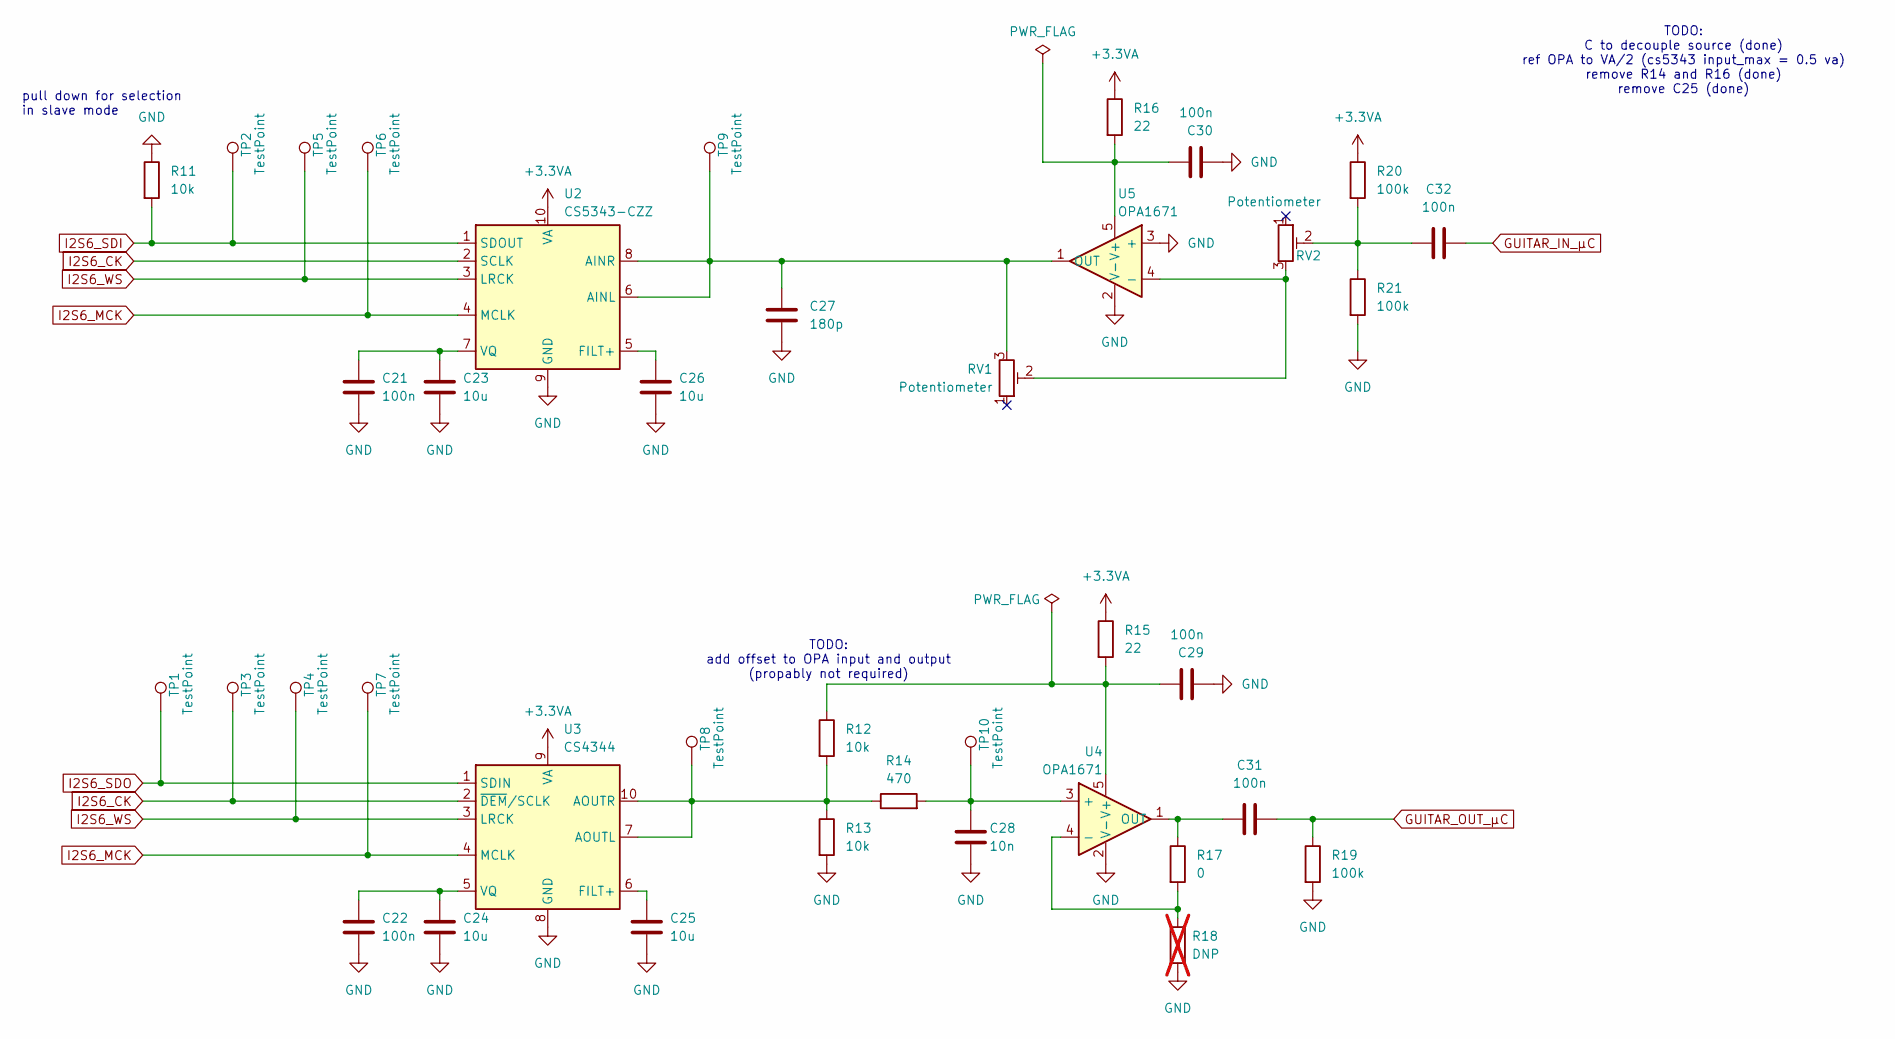
[picture p76: schematic audio.kicad_sch]

Parts:
C21, C22, C29, C30: 100n; C_0402_1005Metric; MOUSER_NR 963-MCASL105SB7104KF
C23, C24, C25, C26: 10u; C_0603_1608Metric; MOUSER_NR 963-LMK107BBJ106MALT
C27: 180p; C_0402_1005Metric; MOUSER_NR 81-GCM1555C1H181JA6D
C28: 10n; C_0402_1005Metric; MOUSER_NR 81-GRM155R61A103KA1D
C31, C32: 100n; C_1210_3225Metric; MOUSER_NR 667-ECH-U1C104JX5
R11, R13: 10k; R_0402_1005Metric; MOUSER_NR 652-CR0402-JW-103GLF
R12: 10k; R_0402_1005Metric; MOUSER_NR 71-CRCW040210K0FKEDC
R14: 470; R_0402_1005Metric; MOUSER_NR 667-ERA-2VEB4700X
R15, R16: 22; R_0603_1608Metric; MOUSER_NR 652-CHP0603QJW-220E
R17: 0; R_0402_1005Metric; MOUSER_NR 710-560112110001
R18: DNP; R_0402_1005Metric; not fitted
R19, R20, R21: 100k; R_0402_1005Metric; MOUSER_NR 652-CR0402JW-104GLF
RV1, RV2: Potentiometer; Potentiometer_Bourns_3224W_Vertical; MOUSER_NR 652-3224W-1-503E
TP1, TP2, TP3, TP4, TP5, TP6, TP7, TP8, TP9, TP10: TestPoint; TestPoint_Pad_D1.5mm
U2: CS5343-CZZ; TSSOP-10_3x3mm_P0.5mm; MOUSER_NR 777-CS5343-CZZ
U3: CS4344; TSSOP-10_3x3mm_P0.5mm; MOUSER_NR 777-CS4344-CZZR
U4, U5: OPA1671; SOT-23-5; MOUSER_NR 595-OPA1671IDBVT

Connections:
+3.3VA: R15.1, R16.1, R20.1, U2.10 (VA), U3.9 (VA); also elsewhere on the board
GND: C21.2, C22.2, C23.2, C24.2, C25.2, C26.2, C27.2, C28.2, C29.2, C30.2, R11.1, R13.2, R18.2, R19.2, R21.2, U2.9 (GND), U3.8 (GND), U4.2 (V-), U5.2 (V-), U5.3 (+); also elsewhere on the board
GUITAR_IN_µC: C32.2; also elsewhere on the board
GUITAR_OUT_µC: C31.2, R19.1; also elsewhere on the board
I2S6_CK: TP3.1, U2.2 (SCLK), U3.2 (~DEM/SCLK); also elsewhere on the board
I2S6_MCK: TP6.1, TP7.1, U2.4 (MCLK), U3.4 (MCLK); also elsewhere on the board
I2S6_SDI: R11.2, TP2.1, U2.1 (SDOUT); also elsewhere on the board
I2S6_SDO: TP1.1, U3.1 (SDIN); also elsewhere on the board
I2S6_WS: TP4.1, TP5.1, U2.3 (LRCK), U3.3 (LRCK); also elsewhere on the board
unnamed: C32.1, R20.2, R21.1, RV2.2
unnamed: C27.1, RV1.3, TP9.1, U2.6 (AINL), U2.8 (AINR), U5.1 (OUT)
unnamed: C26.1, U2.5 (FILT+)
unnamed: C21.1, C23.1, U2.7 (VQ)
unnamed: R12.2, R13.1, R14.1, TP8.1, U3.7 (AOUTL), U3.10 (AOUTR)
unnamed: C25.1, U3.6 (FILT+)
unnamed: C22.1, C24.1, U3.5 (VQ)
unnamed: C28.1, R14.2, TP10.1, U4.3 (+)
unnamed: R17.2, R18.1, U4.4 (-)
unnamed: C31.1, R17.1, U4.1 (OUT)
unnamed: C29.1, R12.1, R15.2, U4.5 (V+)
unnamed: RV1.2, RV2.3, U5.4 (-)
unnamed: C30.1, R16.2, U5.5 (V+)

Notes on the sheet:
TODO: C to decouple source (done) ref OPA to VA/2 (cs5343 input_max = 0.5 va) remove R14 and R16 (done) remove C25 (done)
pull down for selection in slave mode
TODO: add offset to OPA input and output (propably not required)

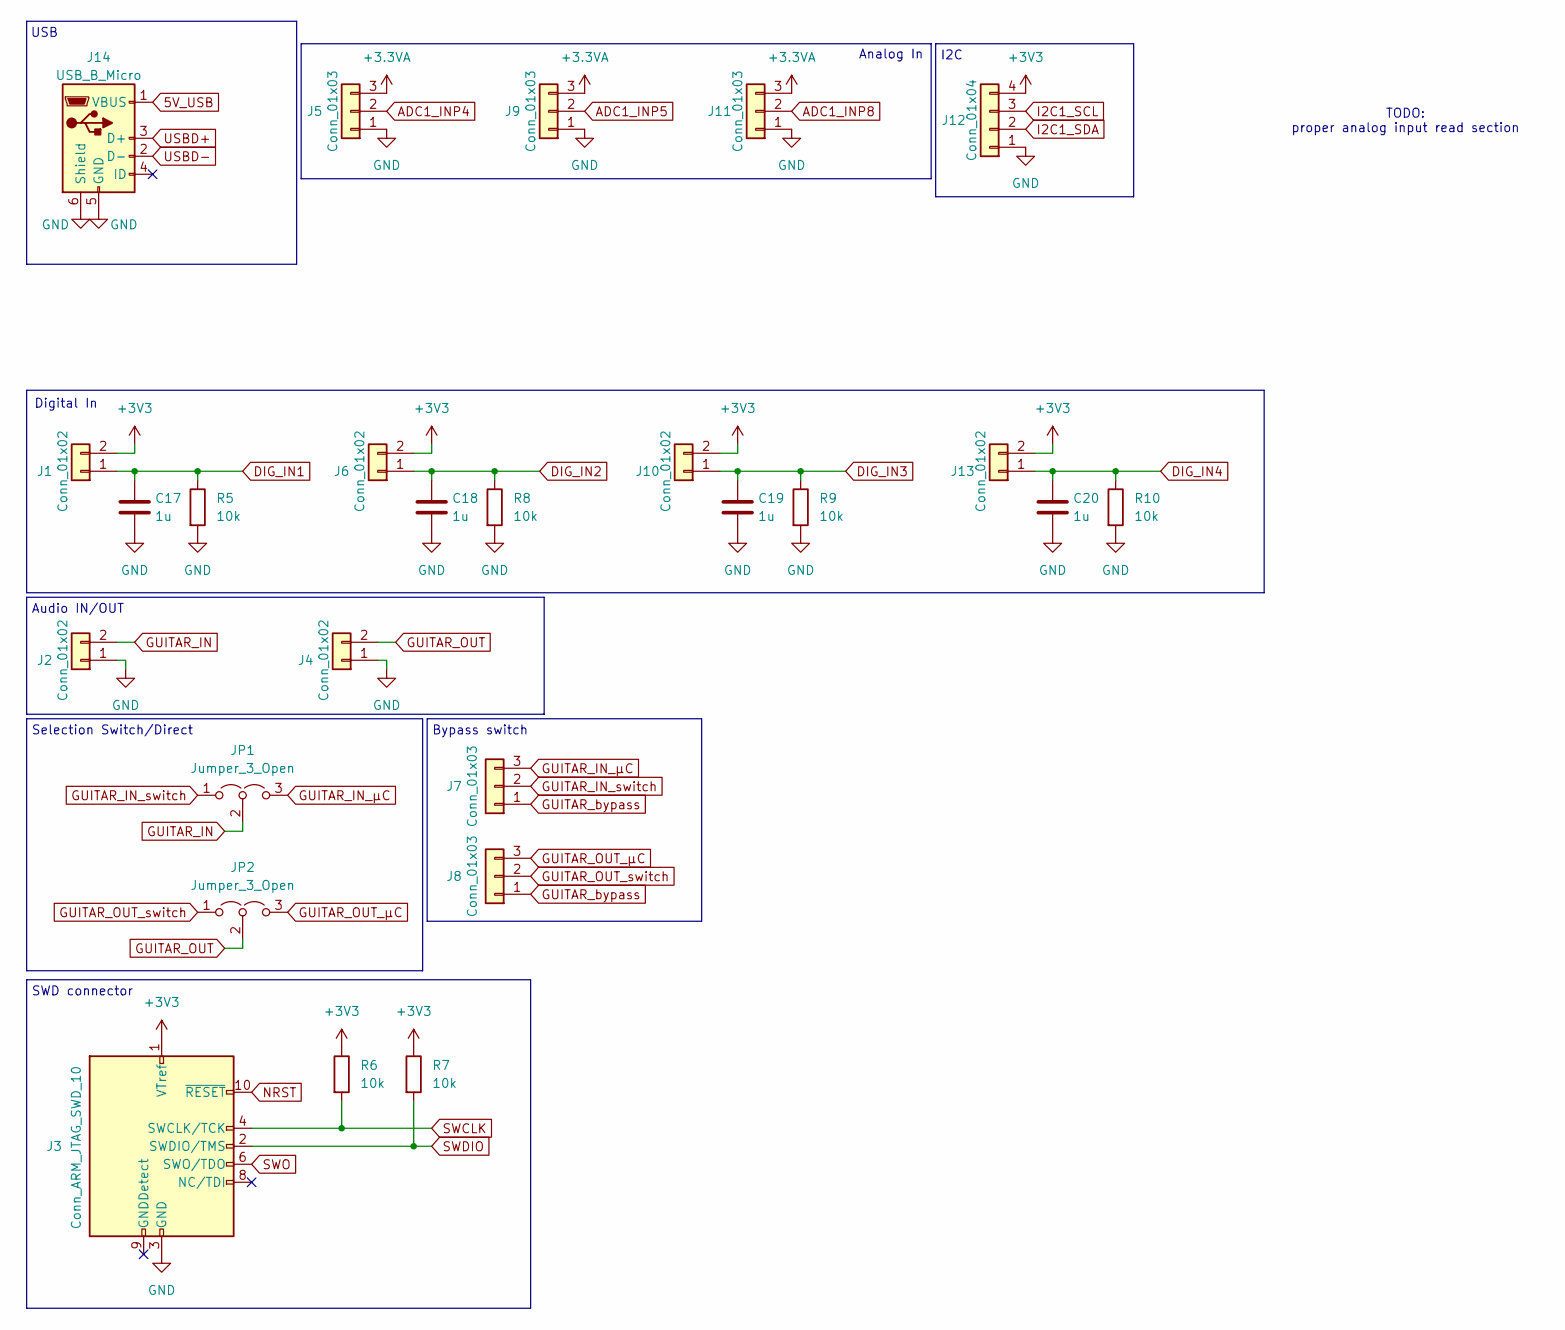
[picture p77: schematic connectors.kicad_sch]

Parts:
C17, C18, C19, C20: 1u; C_0402_1005Metric; MOUSER_NR 963-LMK105BJ105MVHF
J1, J2, J4, J6, J10, J13: Conn_01x02; solder_pad_1x02_D3.5mm
J3: Conn_ARM_JTAG_SWD_10; PinHeader_2x05_P1.27mm_Vertical; MOUSER_NR 474-PRT-15362
J5, J7, J8, J9, J11: Conn_01x03; solder_pad_1x03_D3.5mm
J12: Conn_01x04; PinHeader_1x04_P2.54mm_Vertical
J14: USB_B_Micro; USB_Micro-B_Molex_47346-0001; MOUSER_NR 538-47346-1001
JP1, JP2: Jumper_3_Open; PinHeader_1x03_P2.54mm_Vertical
R5, R6, R7, R8, R9, R10: 10k; R_0402_1005Metric; MOUSER_NR 652-CR0402-JW-103GLF

Connections:
5V_USB: J14.1 (VBUS); also elsewhere on the board
+3.3VA: J5.3, J9.3, J11.3; also elsewhere on the board
+3V3: J1.2, J3.1 (VTref), J6.2, J10.2, J12.4, J13.2, R6.1, R7.1; also elsewhere on the board
ADC1_INP4: J5.2; also elsewhere on the board
ADC1_INP5: J9.2; also elsewhere on the board
ADC1_INP8: J11.2; also elsewhere on the board
DIG_IN1: C17.1, J1.1, R5.1; also elsewhere on the board
DIG_IN2: C18.1, J6.1, R8.1; also elsewhere on the board
DIG_IN3: C19.1, J10.1, R9.1; also elsewhere on the board
DIG_IN4: C20.1, J13.1, R10.1; also elsewhere on the board
GND: C17.2, C18.2, C19.2, C20.2, J2.1, J3.3 (GND), J3.5 (GND), J4.1, J5.1, J9.1, J11.1, J12.1, J14.5 (GND), J14.6 (Shield), R5.2, R8.2, R9.2, R10.2; also elsewhere on the board
GUITAR_IN: J2.2, JP1.2 (C)
GUITAR_IN_switch: J7.2, JP1.1 (A)
GUITAR_IN_µC: J7.3, JP1.3 (B); also elsewhere on the board
GUITAR_OUT: J4.2, JP2.2 (C)
GUITAR_OUT_switch: J8.2, JP2.1 (A)
GUITAR_OUT_µC: J8.3, JP2.3 (B); also elsewhere on the board
GUITAR_bypass: J7.1, J8.1
I2C1_SCL: J12.3; also elsewhere on the board
I2C1_SDA: J12.2; also elsewhere on the board
NRST: J3.10 (~RESET); also elsewhere on the board
SWCLK: J3.4 (SWCLK/TCK), R6.2; also elsewhere on the board
SWDIO: J3.2 (SWDIO/TMS), R7.2; also elsewhere on the board
SWO: J3.6 (SWO/TDO); also elsewhere on the board
USBD+: J14.3 (D+); also elsewhere on the board
USBD-: J14.2 (D-); also elsewhere on the board

Notes on the sheet:
Audio IN/OUT
Selection Switch/Direct
I2C
Analog In
USB
Bypass switch
SWD connector
TODO: proper analog input read section
Digital In

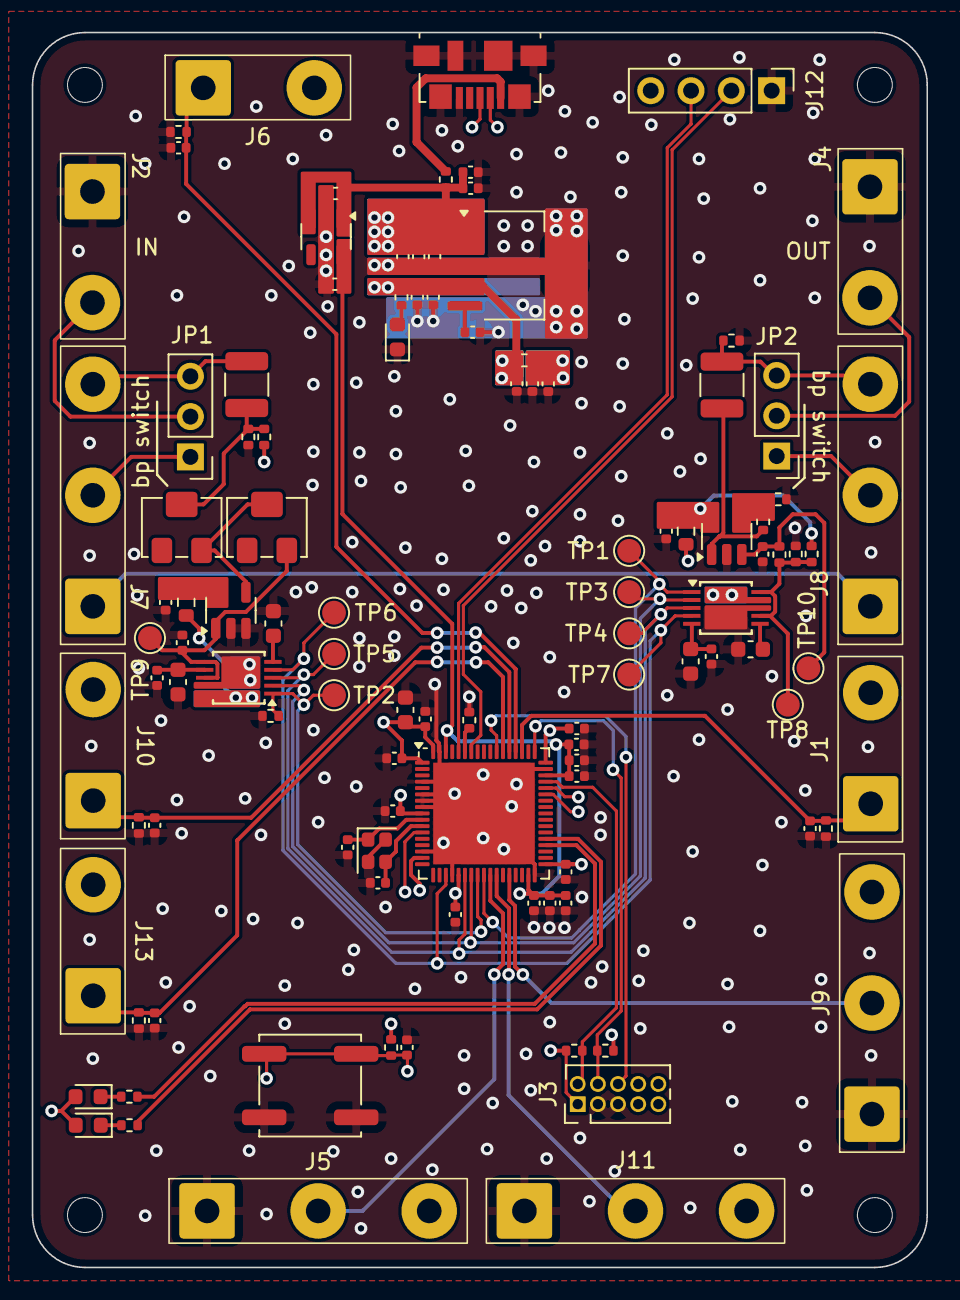
[picture p78: board dispo-board.kicad_pcb from above]

Board: 4 copper layers, 56.4 x 77.8 mm, 109 parts (0 on the bottom side), 55 nets.
