Velmi/guitar-dispo/hardware/hardware.ioc

Mcu.UserName=STM32H725RGVx
PA11.Signal=USB_OTG_HS_DM
PA12.Signal=USB_OTG_HS_DP
PA13(JTMS/SWDIO).Signal=DEBUG_JTMS-SWDIO
PA14(JTCK/SWCLK).Signal=DEBUG_JTCK-SWCLK
PA3.Signal=I2S6_MCK
PA4.Signal=I2S6_WS
PA5.Signal=I2S6_CK
PA6.Signal=I2S6_SDI
PA7.Signal=I2S6_SDO
PA8.Signal=USB_OTG_HS_SOF
PB1.Signal=ADCx_INP5
PB13.Signal=GPIO_Output
PB14.Signal=GPIO_Output
PB15.Signal=GPIO_Output
PB3(JTDO/TRACESWO).Signal=DEBUG_JTDO-SWO
PB7.Signal=I2C1_SDA
PB8.Signal=I2C1_SCL
PC10.Signal=GPIO_Input
PC11.Signal=GPIO_Input
PC12.Signal=GPIO_Input
PC4.Signal=ADCx_INP4
PC5.Signal=ADCx_INP8
PD2.Signal=GPIO_Input
PH0-OSC_IN.Signal=RCC_OSC_IN
PH1-OSC_OUT.Signal=RCC_OSC_OUT
