Velmi/guitar-dispo/software/audio/fir_filter_coeffs.c

#include "fir_filter_coeffs.h"

float32_t fir_coeffs0[] = {
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
		fir_coeffs14,
		fir_coeffs15,
		fir_coeffs16,
		fir_coeffs17,
		fir_coeffs18,
		fir_coeffs19,
		fir_coeffs20,
		fir_coeffs21,
		fir_coeffs22,
		fir_coeffs23,
		fir_coeffs24,
		fir_coeffs25,
		fir_coeffs26,
		fir_coeffs27,
		fir_coeffs28,
		fir_coeffs29,
		fir_coeffs30,
		fir_coeffs31,

};
