Velmi/guitar-dispo/software/audio/audio_proc.cpp

#include <stdint.h>
#include <string.h>
#include "audio_proc.hpp"
#include "effects.hpp"
#include "effectschain.hpp"
#include "fir_filter_coeffs.h"
#include "iir_filter_coeffs.h"

/* store data in ram_d3_data section to allow bdma to access it */
int16_t txBuffer[BUFFER_SIZE] __attribute__((section(".ram_d3_data")));
int16_t rxBuffer[BUFFER_SIZE] __attribute__((section(".ram_d3_data")));

int16_t* pInput;
int16_t* pOutput;

float32_t txBufferf[BUFFER_SIZE/2];
float32_t rxBufferf[BUFFER_SIZE/2];

uint16_t adcVal[10];
uint32_t adcAvg = 0;

// FIRInstance firInstance {fir_coeffs_lut, FILTER_TAPS, sizeof(fir_coeffs_lut)/sizeof(float32_t*)};
// FIRFilter firFilter {firInstance, 1};

// effects::WahWah wahwah{430, 2300, 5, AUDIO_SAMPLING_FREQ_HZ, 2700, 14000};
// effects::Delay<10000> delay;
// effects::Chorus<2000> chorus{1.0f, 250, 0.5f};
EffectsChain effectschain;


void convert_to_float(int16_t* input, float32_t* output)
{
	for(size_t i = 0; i < PROCESS_BLOCK_SIZE; i++)
	{
		output[i] = (input[2*i] / 2) + (input[2*i + 1] / 2);
	}
}

void convert_to_in16_t(float32_t* input, int16_t* output)
{
	for(size_t i = 0; i < PROCESS_BLOCK_SIZE; i++)
	{
		output[2*i]     = (int16_t)(input[i]);
		output[2*i + 1] = (int16_t)(input[i]);
	}
}

void audio_init()
{
	effectschain.addChorus();
	effectschain.addWahWah();
}

void process_data()
{
	//effects::passthrough(pInput, pOutput);
	convert_to_float(pInput, rxBufferf);
	//wahwah.process(rxBufferf, txBufferf, BUFFER_SIZE/4, adcVal[0]);
	
	//wahwah.process(rxBufferf, temp, PROCESS_BLOCK_SIZE, adcVal[0]);
	//chorus.process(rxBufferf,txBufferf, PROCESS_BLOCK_SIZE);
	
	effectschain.process(rxBufferf, txBufferf, PROCESS_BLOCK_SIZE);

	convert_to_in16_t(txBufferf, pOutput);
}

void HAL_I2SEx_TxRxCpltCallback(I2S_HandleTypeDef *hi2s)
{
	pInput = &rxBuffer[BUFFER_SIZE/2];
	pOutput = &txBuffer[BUFFER_SIZE/2];
	//osEventFlagsSet(audioDataReadyFlag, AUDIO_DATA_READY_FLAG);
	process_data();
}

void HAL_I2SEx_TxRxHalfCpltCallback(I2S_HandleTypeDef *hi2s)
{
	pInput = &rxBuffer[0];
	pOutput = &txBuffer[0];
	//osEventFlagsSet(audioDataReadyFlag, AUDIO_DATA_READY_FLAG);
	process_data();
}

void HAL_I2S_ErrorCallback(I2S_HandleTypeDef *hi2s)
{
	uint32_t err = hi2s->ErrorCode;
}

void HAL_ADC_ConvHalfCpltCallback(ADC_HandleTypeDef* hadc) {
	HAL_GPIO_TogglePin(GPIOB, GPIO_PIN_14);
}

void HAL_ADC_ConvCpltCallback(ADC_HandleTypeDef* hadc) {
  HAL_GPIO_TogglePin(GPIOB, GPIO_PIN_14);
}
