Velmi/guitar-dispo/software/audio/iir_filter_coeffs.h

#ifndef IIR_FILTER_COEFFS_H_
#define IIR_FILTER_COEFFS_H_

#ifdef __cplusplus
extern "C" {
#endif

#include "stdint.h"
#include "arm_math.h"

extern const float32_t* iir_coeffs_lut[33];

#ifdef __cplusplus
}
#endif

#endif /* IIR_FILTER_COEFFS_H_ */
