Velmi/guitar-dispo/(commit log)

2023-07-27 added STM32CubeIDE project
2023-08-01 added CLI, added bandpass filter, added lowpass filter to poti-ADC
2023-08-06 added kicad project
    [dispo-board.kicad_pcb, dispo-board.kicad_sch]
2023-11-22 power, quarz, switch to internal USB
    [connectors.kicad_sch, dispo-board.kicad_sch]
2024-03-10 add decoupling caps, connectors, audio, minor corrections in report
    [audio.kicad_sch, connectors.kicad_sch, dispo-board.kicad_sch]
2024-03-21 added analog frontend
    [audio.kicad_sch, connectors.kicad_sch, dispo-board.kicad_sch]
2024-03-24 maybe final schematic?
    [audio.kicad_sch, connectors.kicad_sch, dispo-board.kicad_sch]
2024-03-29 added debugger, corrected erc errors
    [audio.kicad_sch, connectors.kicad_sch, dispo-board.kicad_sch]
2024-03-30 added footprints and mouser nrs
    [audio.kicad_sch, connectors.kicad_sch, dispo-board.kicad_sch]
2024-04-07 few changes supply op amp, anaolg input and output, updated footprints and mouser nrs
    [audio.kicad_sch, connectors.kicad_sch, dispo-board.kicad_sch]
2024-04-14 added missing footprint
    [connectors.kicad_sch]
2024-04-24 updated footprints, pcb
    [audio.kicad_sch, connectors.kicad_sch, dispo-board.kicad_pcb, dispo-board.kicad_sch]
2024-04-30 pcb layout drc check passed
    [dispo-board.kicad_pcb]
2024-04-30 corrected vias and placements
    [dispo-board.kicad_pcb]
2024-05-02 updated pcb, changed via sizes, drc check, ...
    [dispo-board.kicad_pcb]
2024-06-27 pcb and parts ordered like this
    [audio.kicad_sch, bom.csv, bom_expanded.ods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]
2024-07-08 error in schematic: no LDO on package, must use SMPS, switched to kicad 8, modified filter script
    [audio.kicad_sch, connectors.kicad_sch, dispo-board.kicad_sch]
2024-08-20 added pcb
2024-09-11 basic software, bandpass fir filter, added notes to hardware modifications
    [audio.kicad_sch]
2024-09-13 fir and iir filter working at right frequencies
2024-09-13 scripts for filterdesign working
2024-09-13 audio nucleo changes, kicad notes for hardware issues
    [audio.kicad_sch]
2024-09-15 abgabe version
    [audio.kicad_sch, connectors.kicad_sch, dispo-board.kicad_sch]
2024-11-02 new abgabe version
    [analog_bandpass.csv]
2025-06-01 bypassing filter when pedal completely released
2025-07-06 schematic should be ready, changed parts, ...
    [audio.kicad_sch, bom.csv, connectors.kicad_sch, dispo-board.kicad_sch, power.kicad_sch]
2025-07-27 deleted nucleo board files, schematic ready?, changed to usb c
    [audio.kicad_sch, connectors.kicad_sch, dispo-board.kicad_sch, power.kicad_sch]
2025-08-03 changed to old ldo
    [dispo-board.kicad_pcb, power.kicad_sch]
2025-08-03 corrected ldo schematic
    [power.kicad_sch]
2025-08-03 annotate schmetic
    [audio.kicad_sch, connectors.kicad_sch, power.kicad_sch]
2025-11-11 shorted board
    [audio.kicad_sch, dispo-board.kicad_pcb, power.kicad_sch]
2025-11-23 routed i2s and analog and digital pins, rst button and debug connector not finished
    [dispo-board.kicad_pcb]
2025-12-26 routing almost finished, need GND plane
    [audio.kicad_sch, dispo-board.kicad_pcb]
2026-01-17 changed again to micro usb, resolved spacing issues
    [connectors.kicad_sch, dispo-board.kicad_pcb]
2026-01-18 everything connected, ready?
    [dispo-board.kicad_pcb]
2026-01-21 changed text sizes, some other stuff
    [dispo-board.kicad_pcb]
2026-01-21 added some text, minor changes, should be ready for production
    [dispo-board.kicad_pcb]
2026-01-25 added manifacturing files
    [bom.csv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]
2026-01-31 ordered pcb and stuff
    [audio.kicad_sch, bom_expanded.csv, connectors.kicad_sch, dispo-board.kicad_sch, power.kicad_sch]
2026-02-16 bom and stuff
    [bom_expanded.csv]
